aesirkth/surtr-hardware/launchpad-controller-v2.jpg

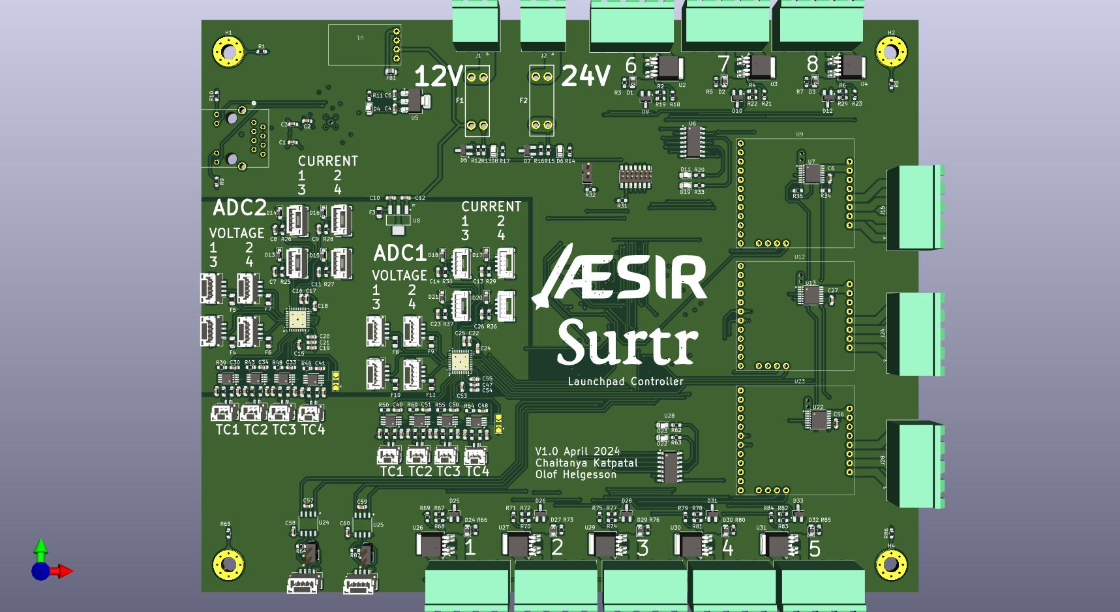
launchpad-controller-v2.jpg
