aesirkth/surtr-hardware/launchpad-controller-v2.png

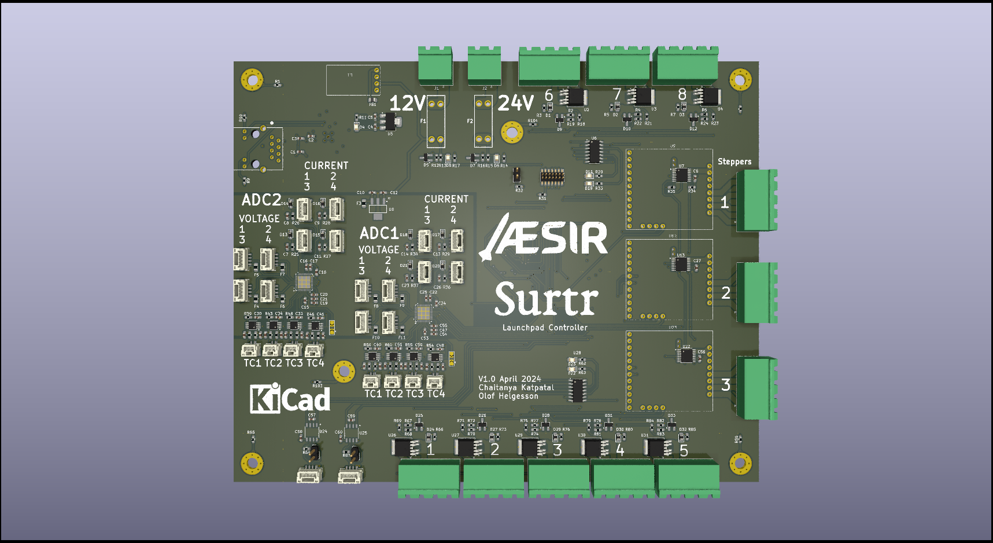
launchpad-controller-v2.png
