aesirkth/surtr-hardware/pdf/launchpad-controller-v2.pdf

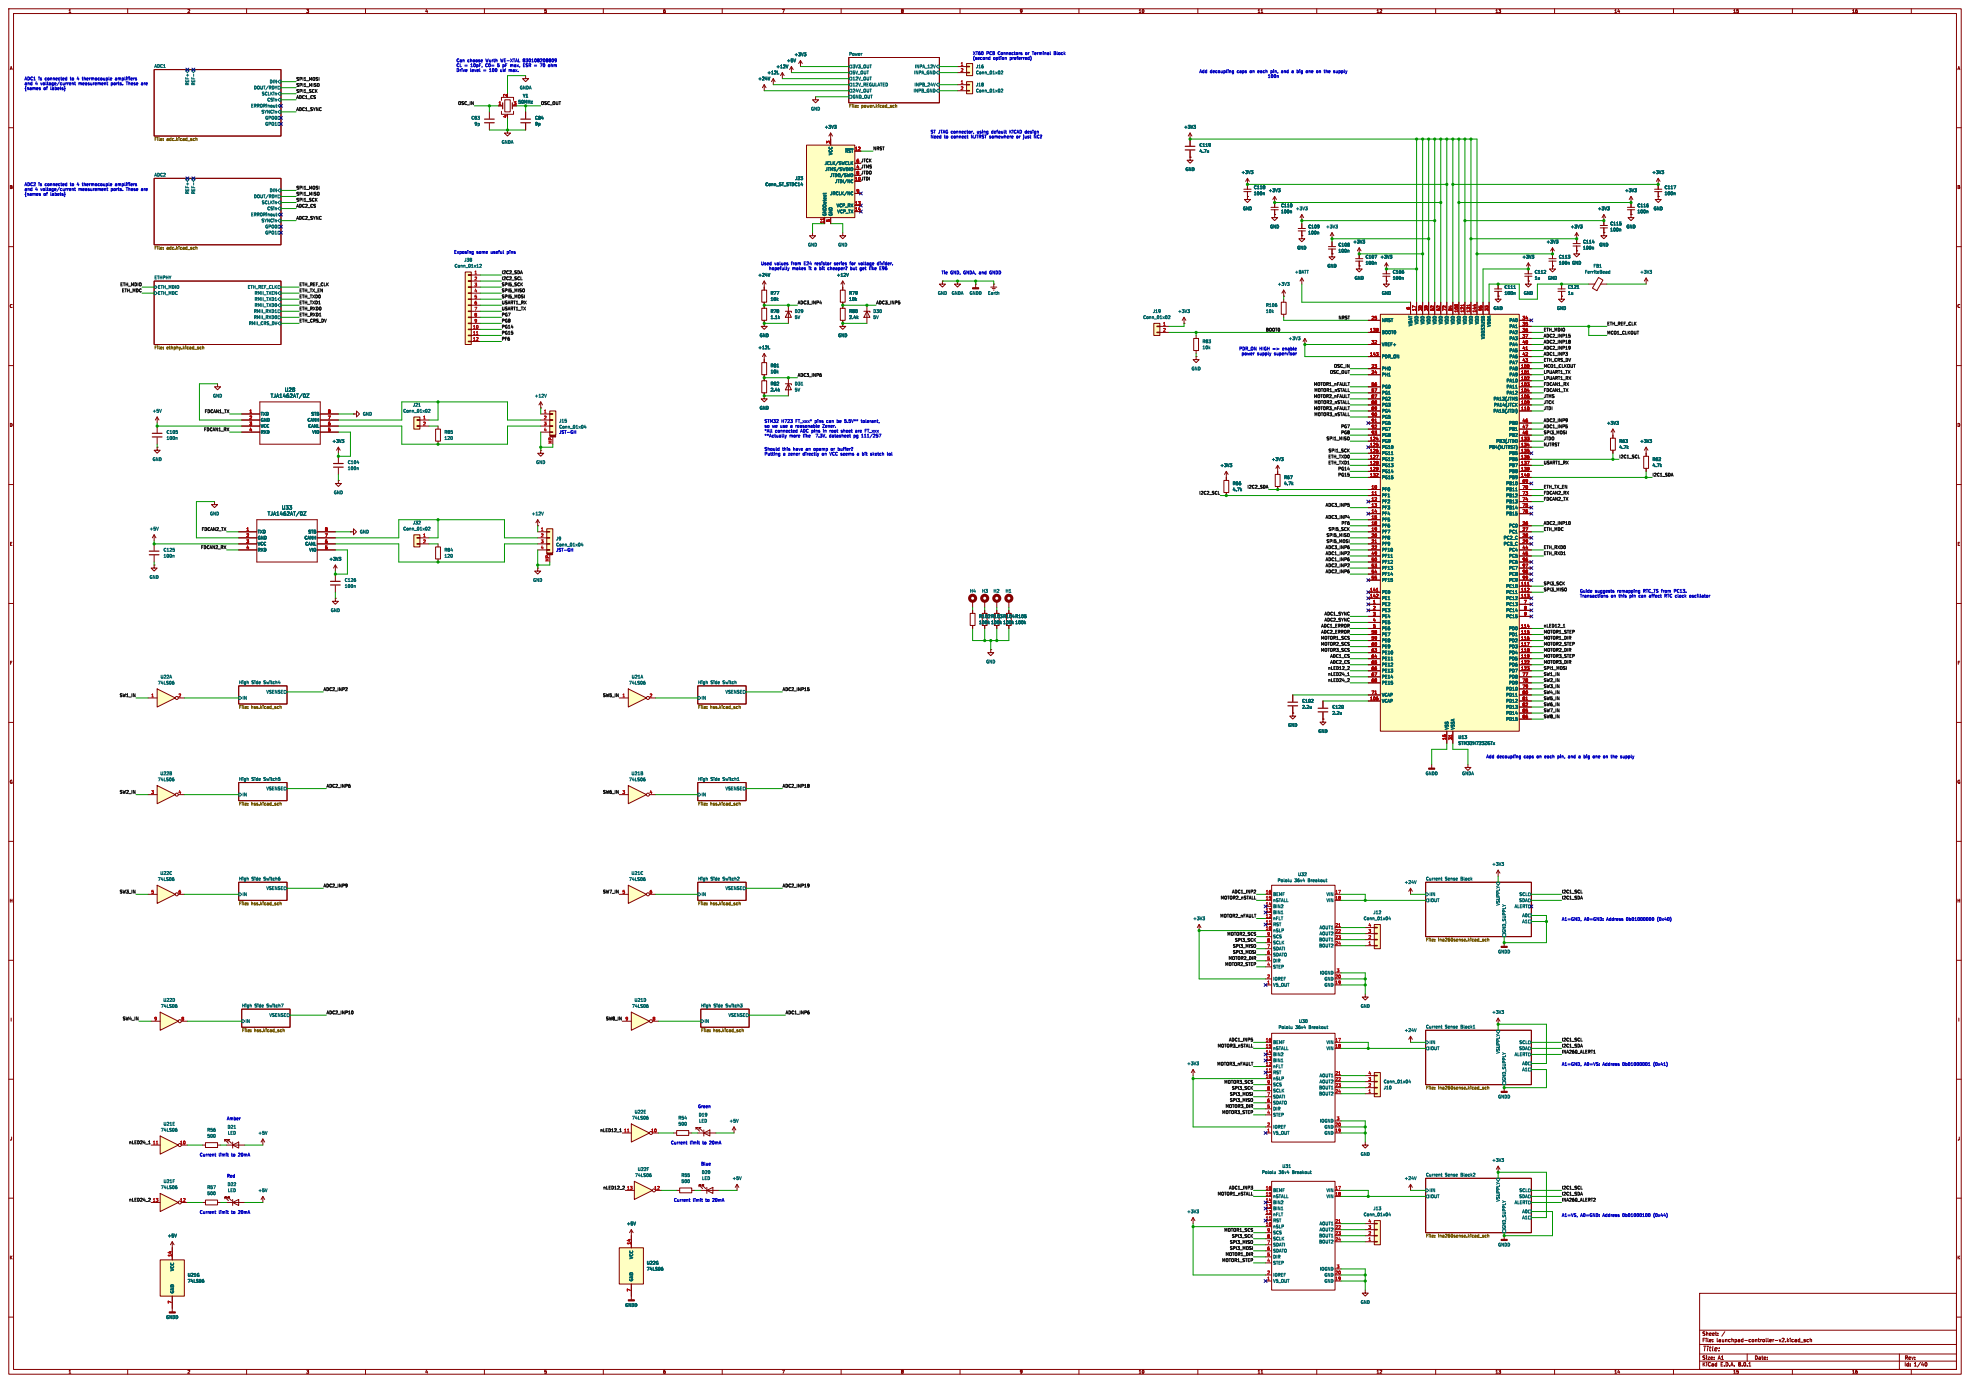
[picture p3: page 1]

Drive level = 100 uW max.

Tie GND, GNDA, and GNDD

VSENSE High Side Switch4 File: hss.kicad_sch

VSENSE High Side Switch File: hss.kicad_sch

VSENSE High Side Switch1 File: hss.kicad_sch

VSENSE High Side Switch6 File: hss.kicad_sch

VSENSE High Side Switch2 File: hss.kicad_sch

VSENSE High Side Switch7 File: hss.kicad_sch

VSENSE High Side Switch3 File: hss.kicad_sch

Amber Current limit to 20mA

Id: 1/40 Title: File: launchpad-controller-v2.kicad_sch Sheet: /

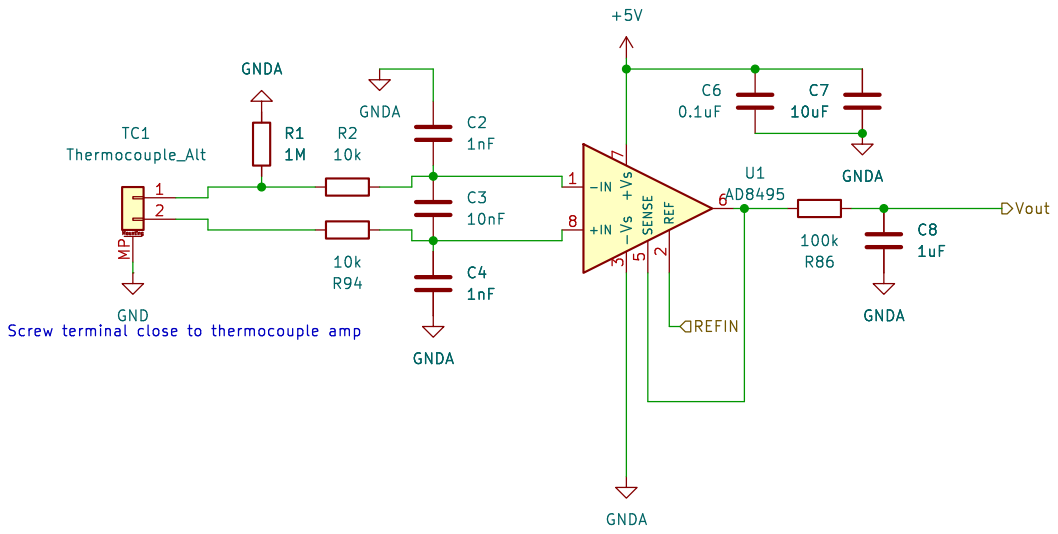
[picture p4: page 2]

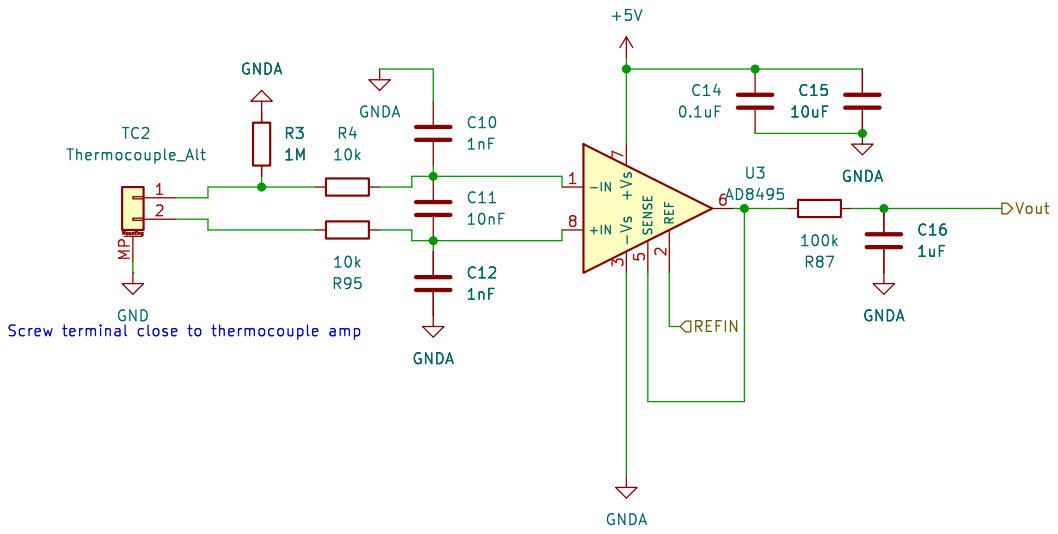
[picture p5: page 3]

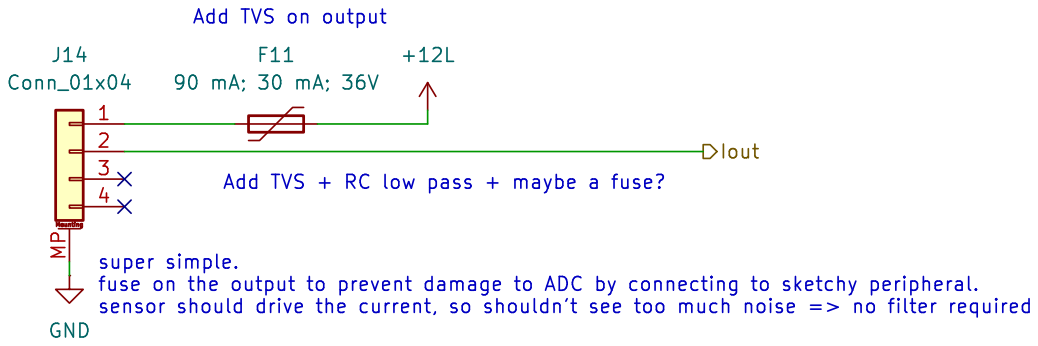
[picture p6: page 4]

Iout Add TVS on output Add TVS + RC low pass + maybe a fuse?
J14 Conn_01x04 GND

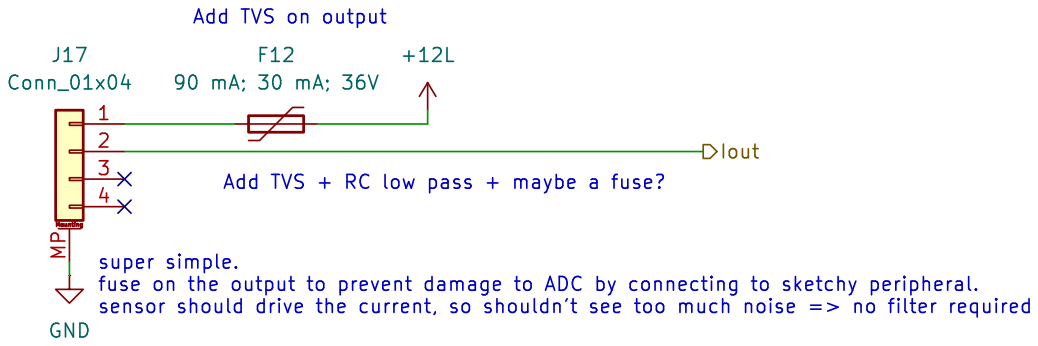
[picture p7: page 5]

Iout Add TVS on output Add TVS + RC low pass + maybe a fuse?
J17 Conn_01x04 GND

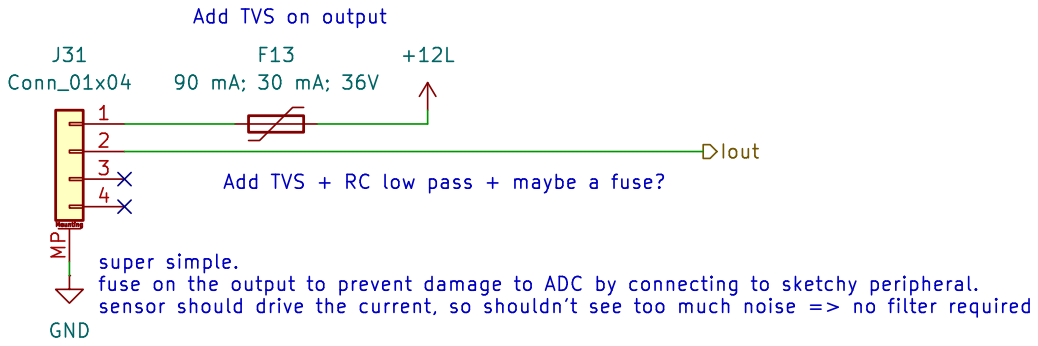
[picture p8: page 6]

Iout Add TVS on output Add TVS + RC low pass + maybe a fuse?
J31 Conn_01x04 GND

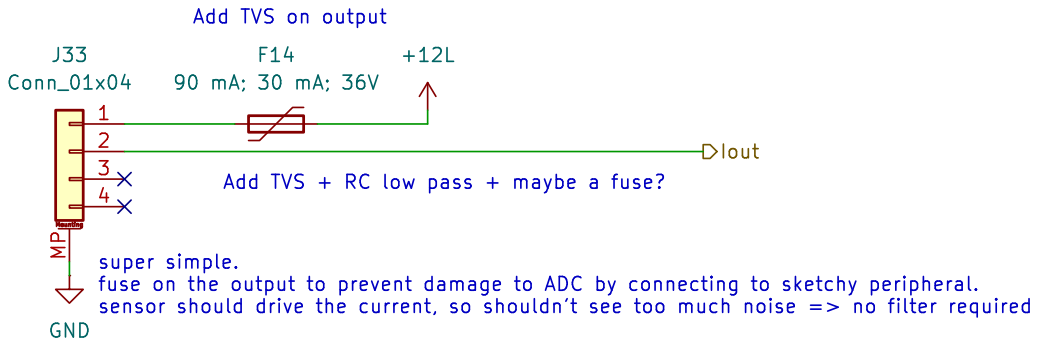
[picture p9: page 7]

Iout Add TVS on output Add TVS + RC low pass + maybe a fuse?
J33 Conn_01x04 GND

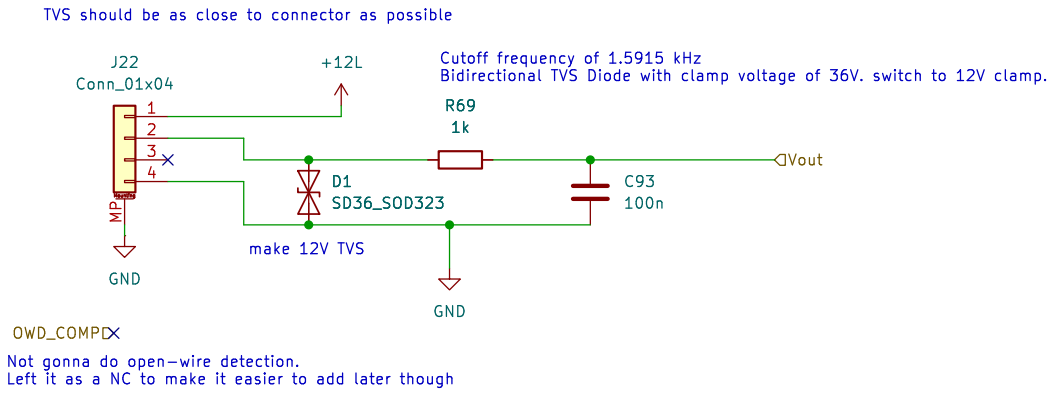
[picture p10: page 8]

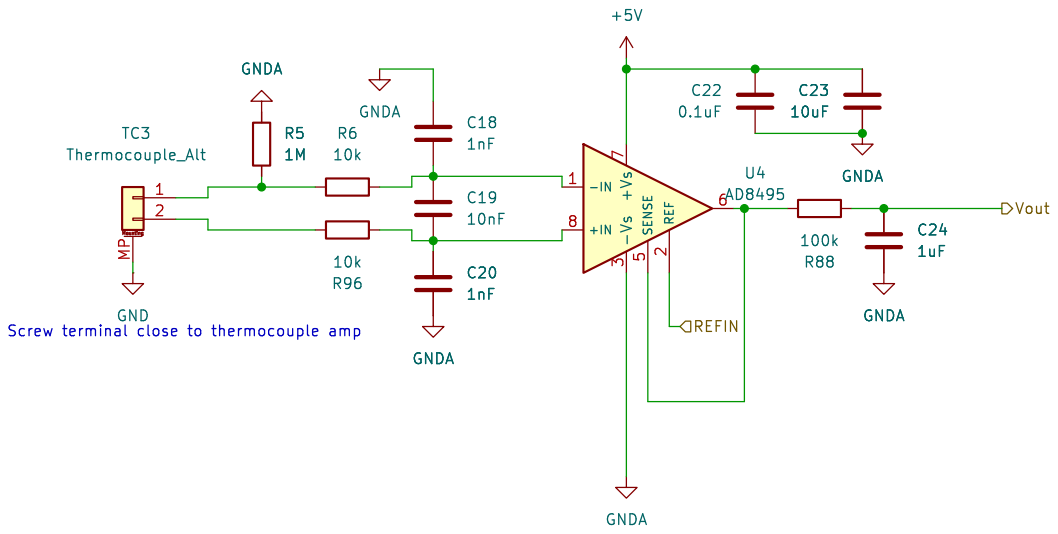
[picture p11: page 9]

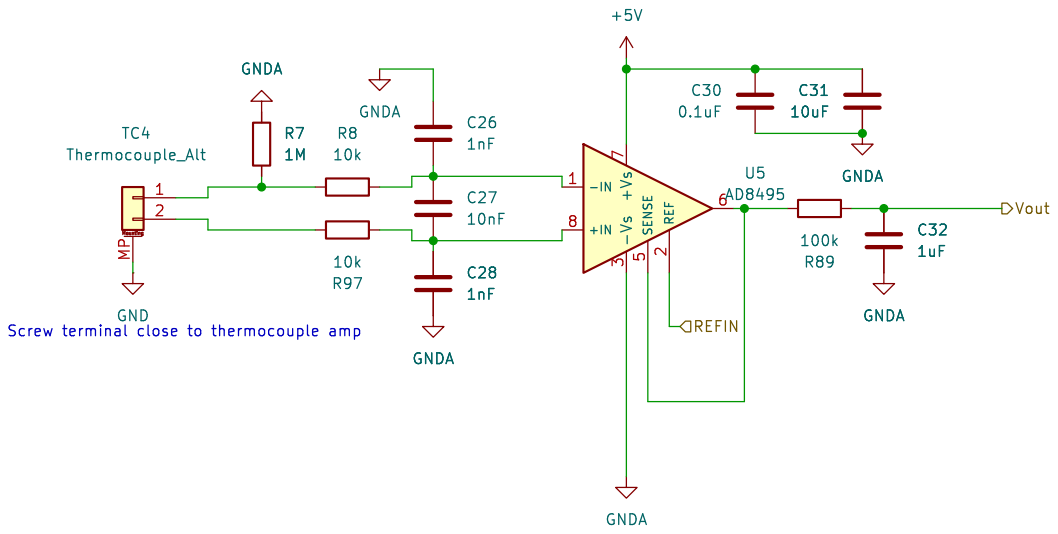
[picture p12: page 10]

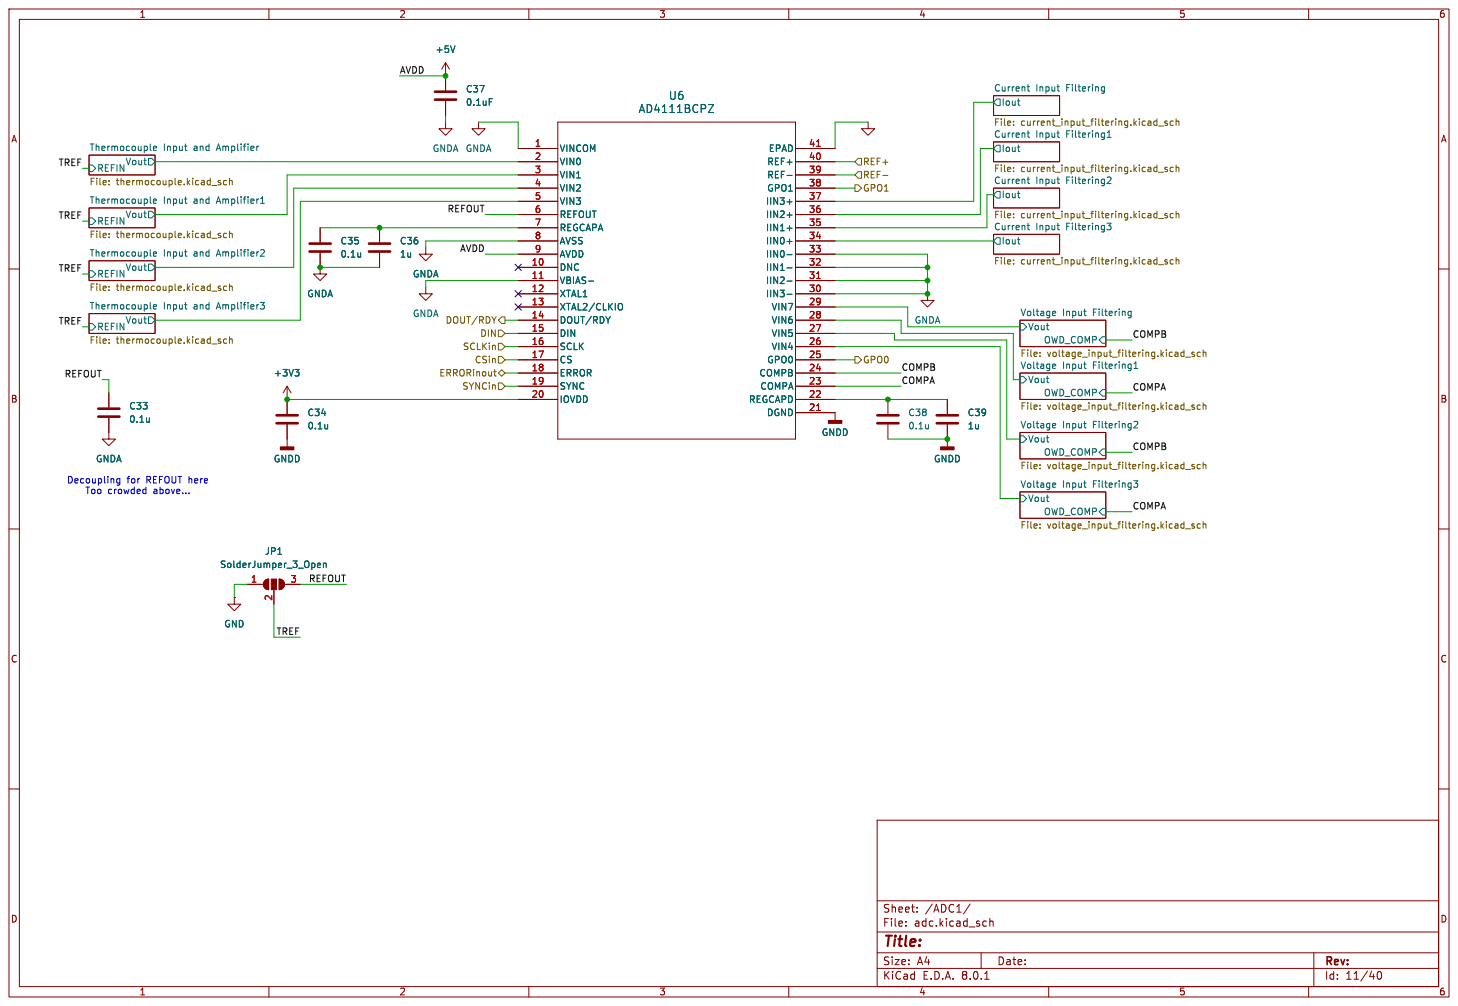
[picture p13: page 11]

Iout Current Input Filtering File: current_input_filtering.kicad_sch Vout REFIN

Iout Current Input Filtering1 File: current_input_filtering.kicad_sch

Voltage Input Filtering File: voltage_input_filtering.kicad_sch Vout REFIN

Iout Current Input Filtering2 File: current_input_filtering.kicad_sch

Iout Current Input Filtering3 File: current_input_filtering.kicad_sch VoutOWD_COMP

Id: 11/40 Title: File: adc.kicad_sch Sheet: /ADC1/

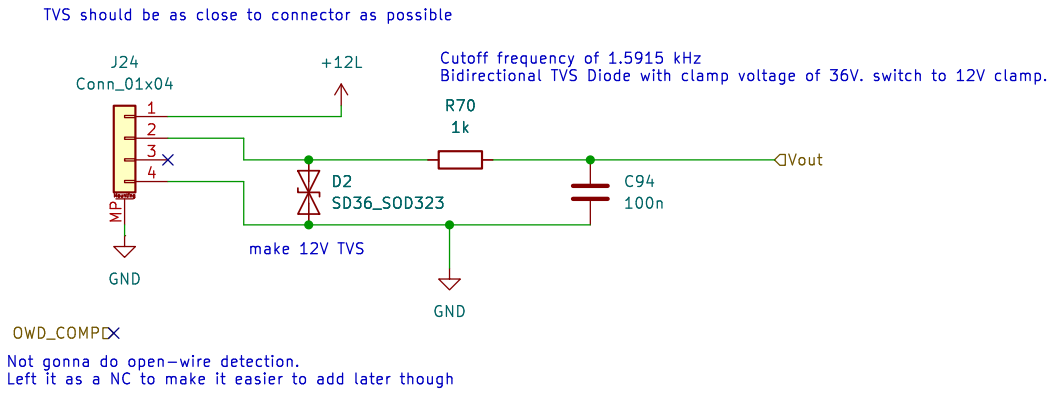
[picture p14: page 12]

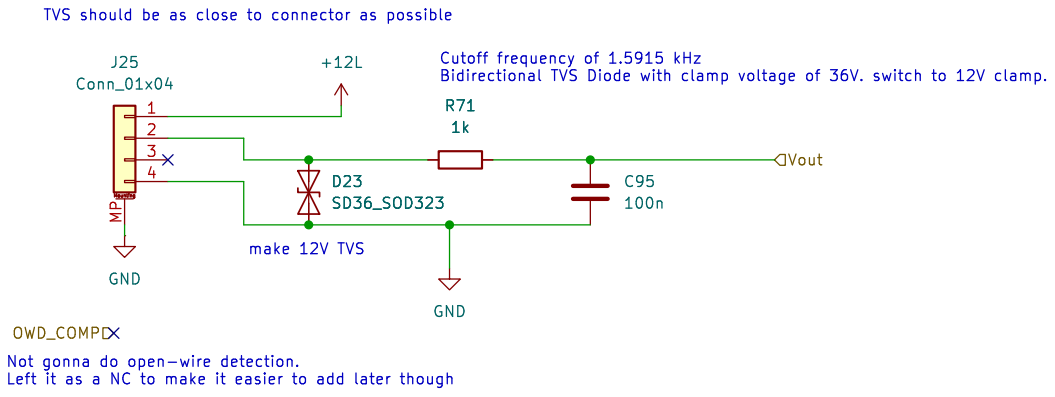
[picture p15: page 13]

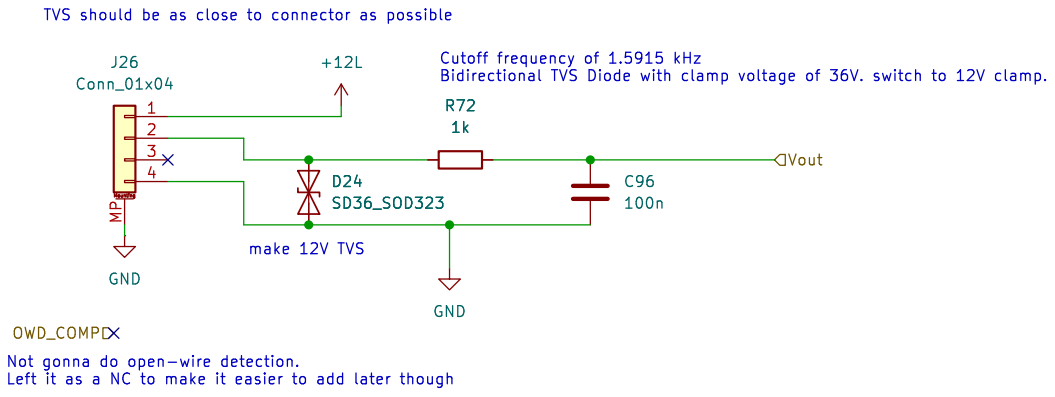
[picture p16: page 14]

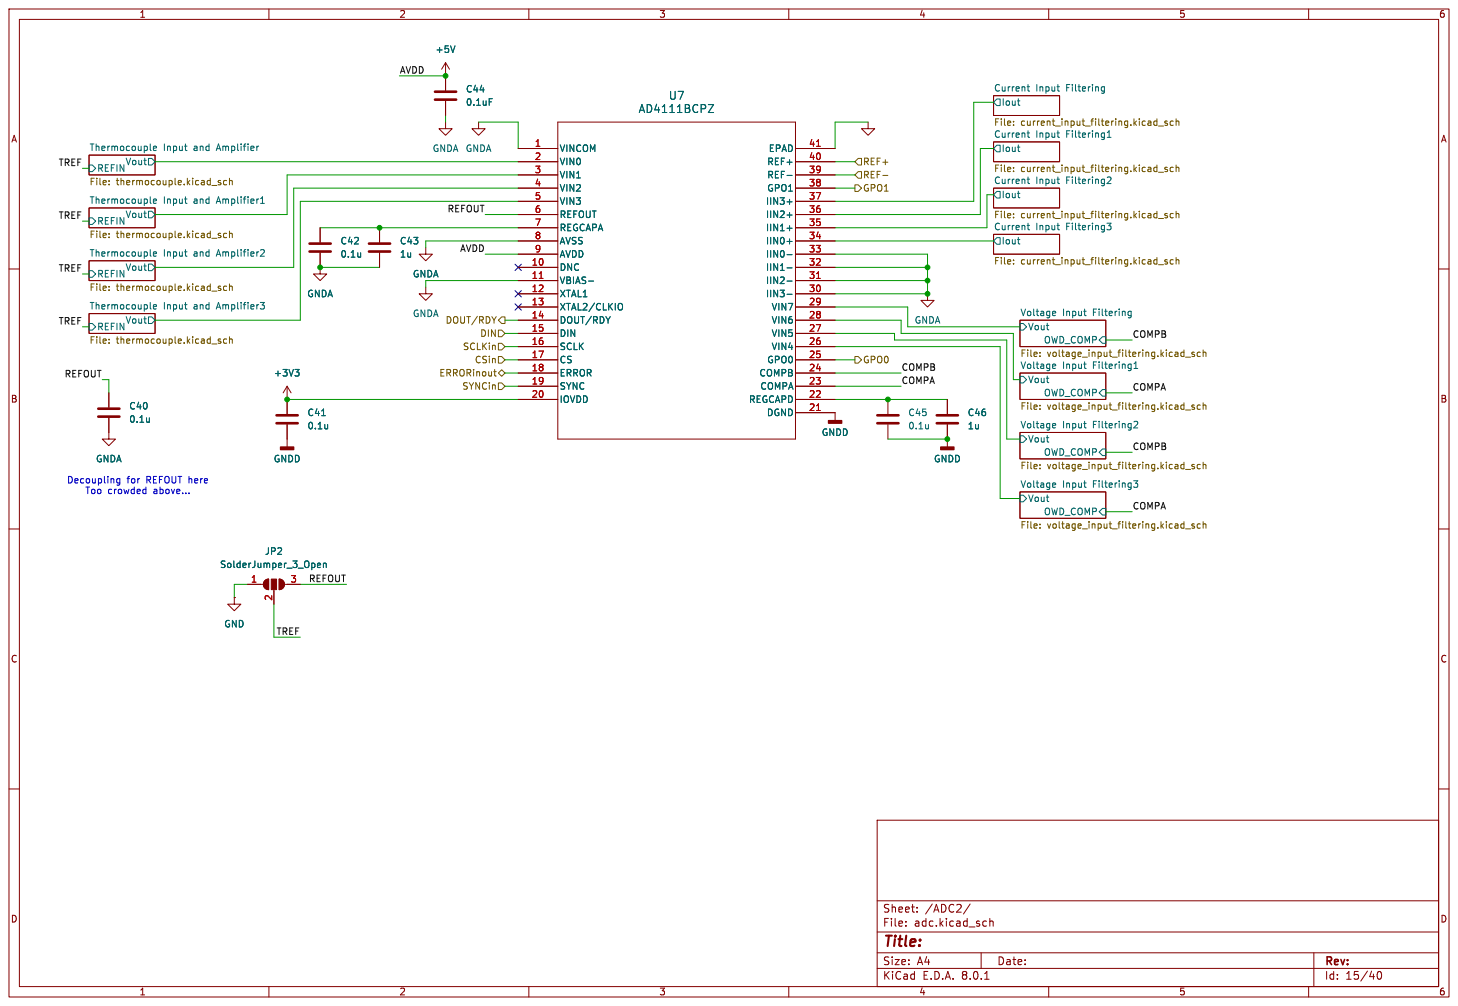
[picture p17: page 15]

Iout Current Input Filtering File: current_input_filtering.kicad_sch Vout REFIN

Iout Current Input Filtering1 File: current_input_filtering.kicad_sch

Iout Current Input Filtering2 File: current_input_filtering.kicad_sch

Iout Current Input Filtering3 File: current_input_filtering.kicad_sch VoutOWD_COMP

Voltage Input Filtering File: voltage_input_filtering.kicad_sch Vout REFIN

Id: 15/40 Title: File: adc.kicad_sch Sheet: /ADC2/

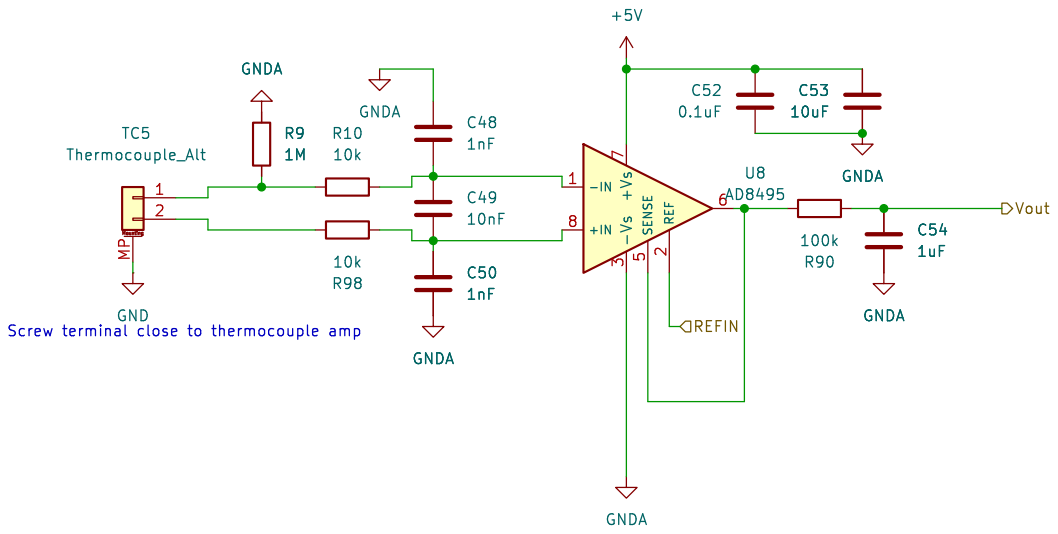
[picture p18: page 16]

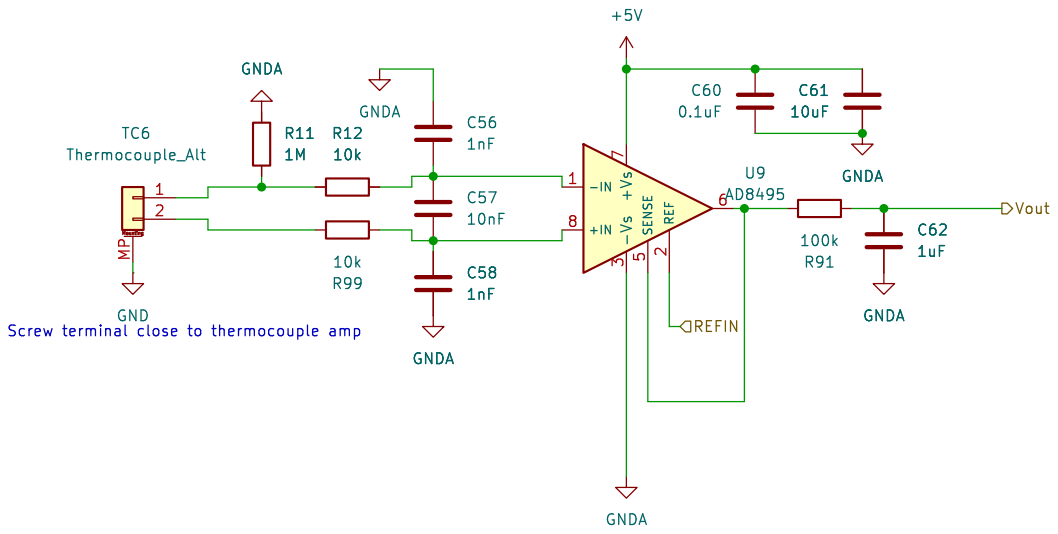
[picture p19: page 17]

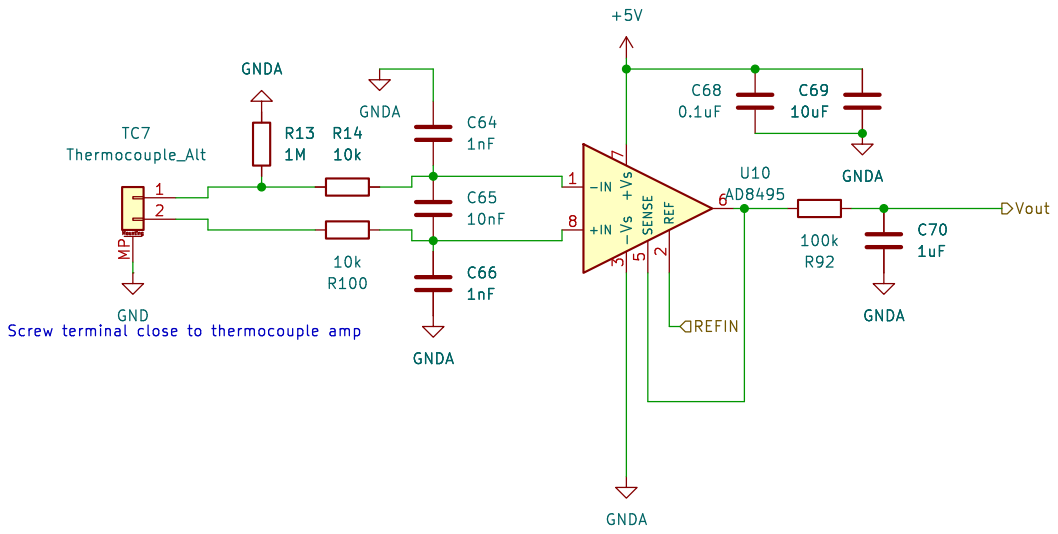
[picture p20: page 18]

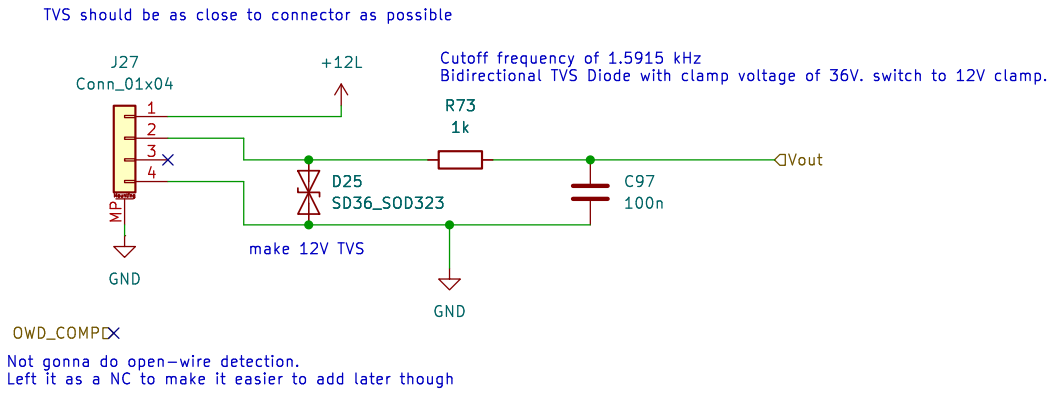
[picture p21: page 19]

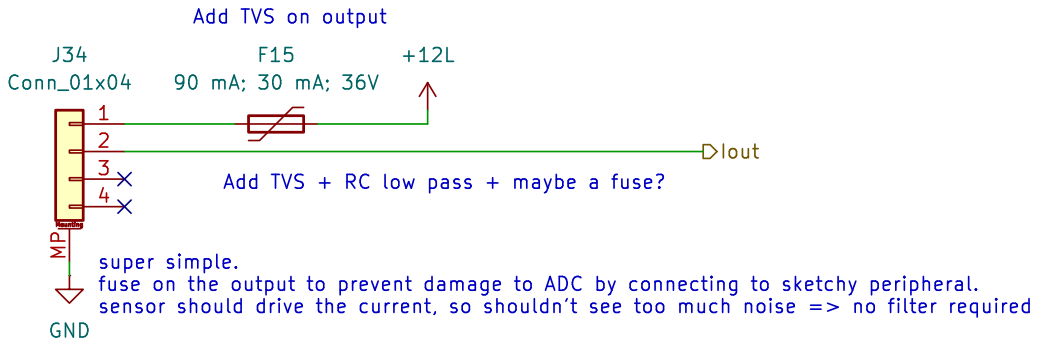
[picture p22: page 20]

Iout Add TVS on output Add TVS + RC low pass + maybe a fuse?
J34 Conn_01x04 GND

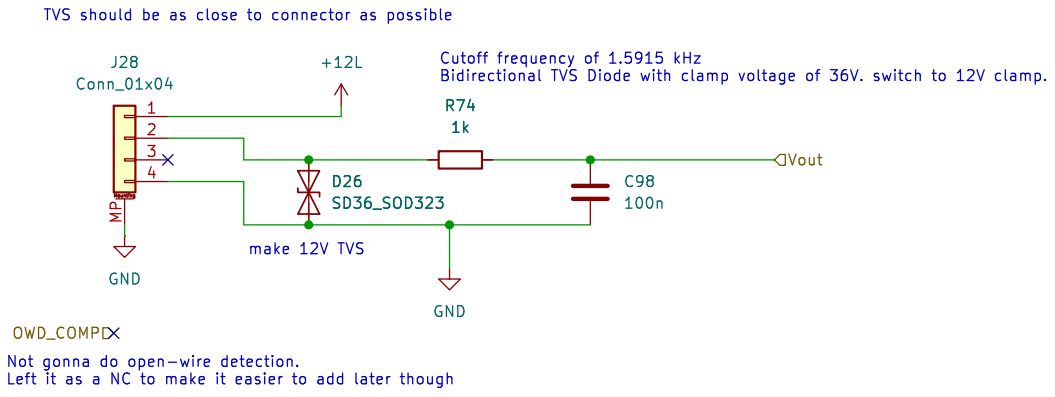
[picture p23: page 21]

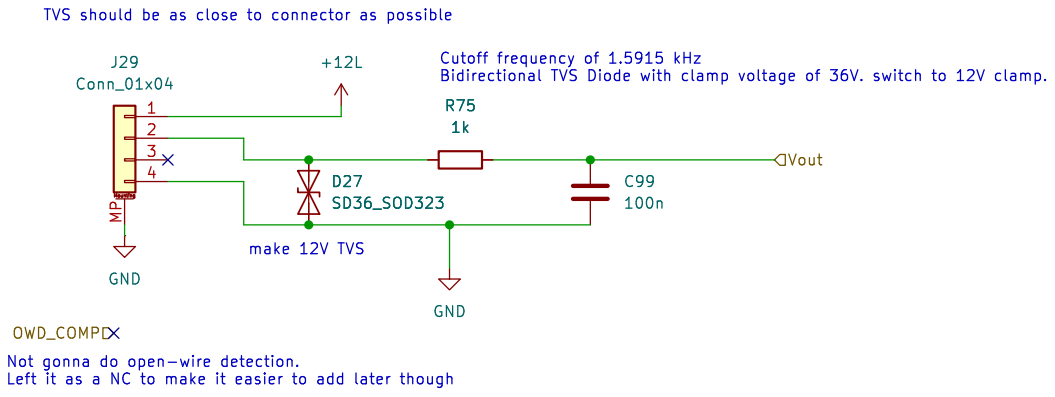
[picture p24: page 22]

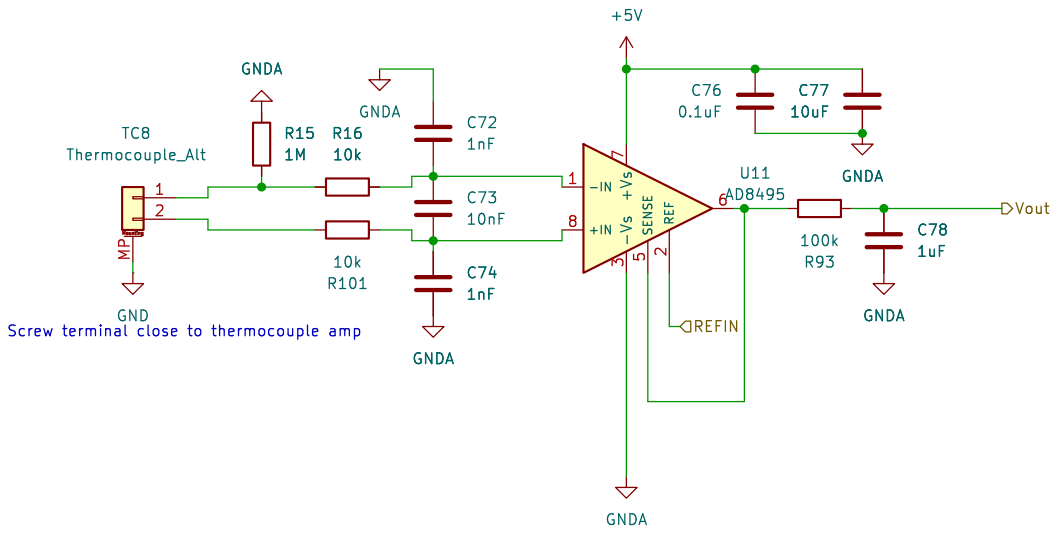
[picture p25: page 23]

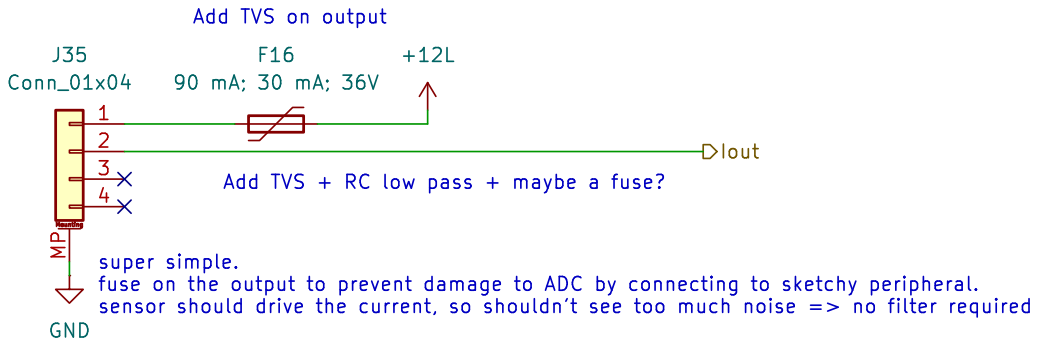
[picture p26: page 24]

Iout Add TVS on output Add TVS + RC low pass + maybe a fuse?
J35 Conn_01x04 GND

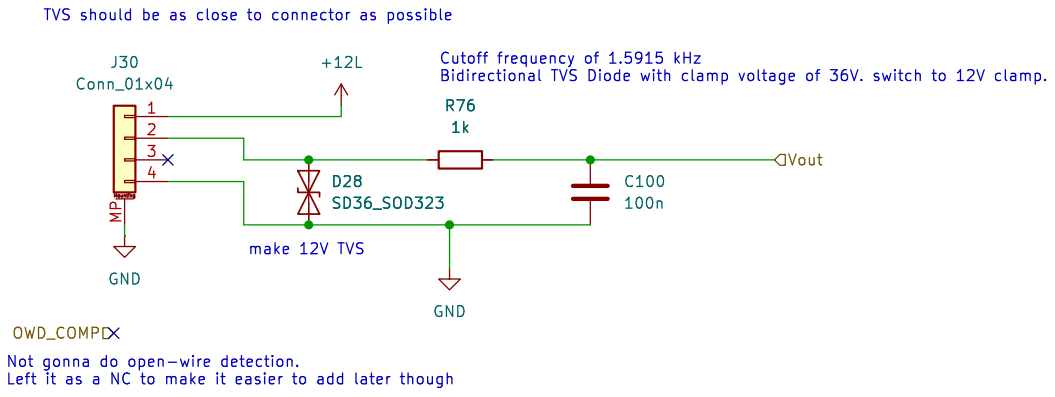
[picture p27: page 25]

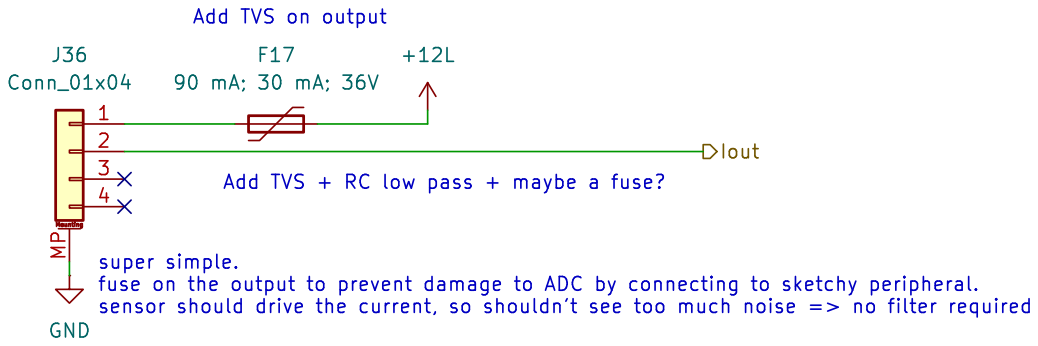
[picture p28: page 26]

Iout Add TVS on output Add TVS + RC low pass + maybe a fuse?
J36 Conn_01x04 GND

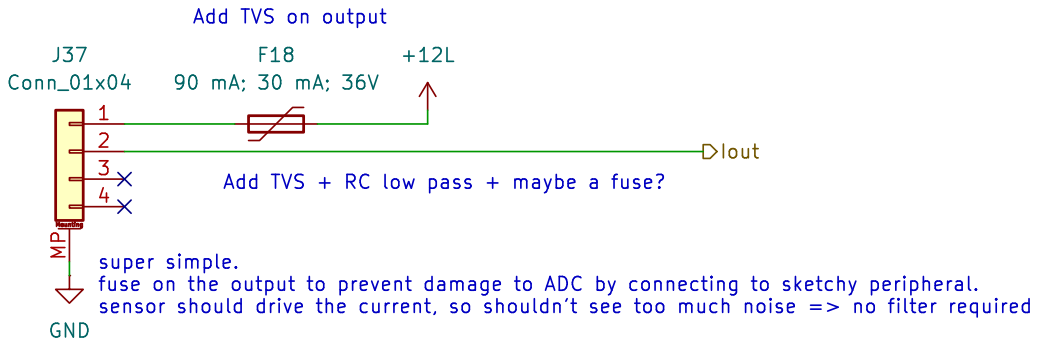
[picture p29: page 27]

Iout Add TVS on output Add TVS + RC low pass + maybe a fuse?
J37 Conn_01x04 GND

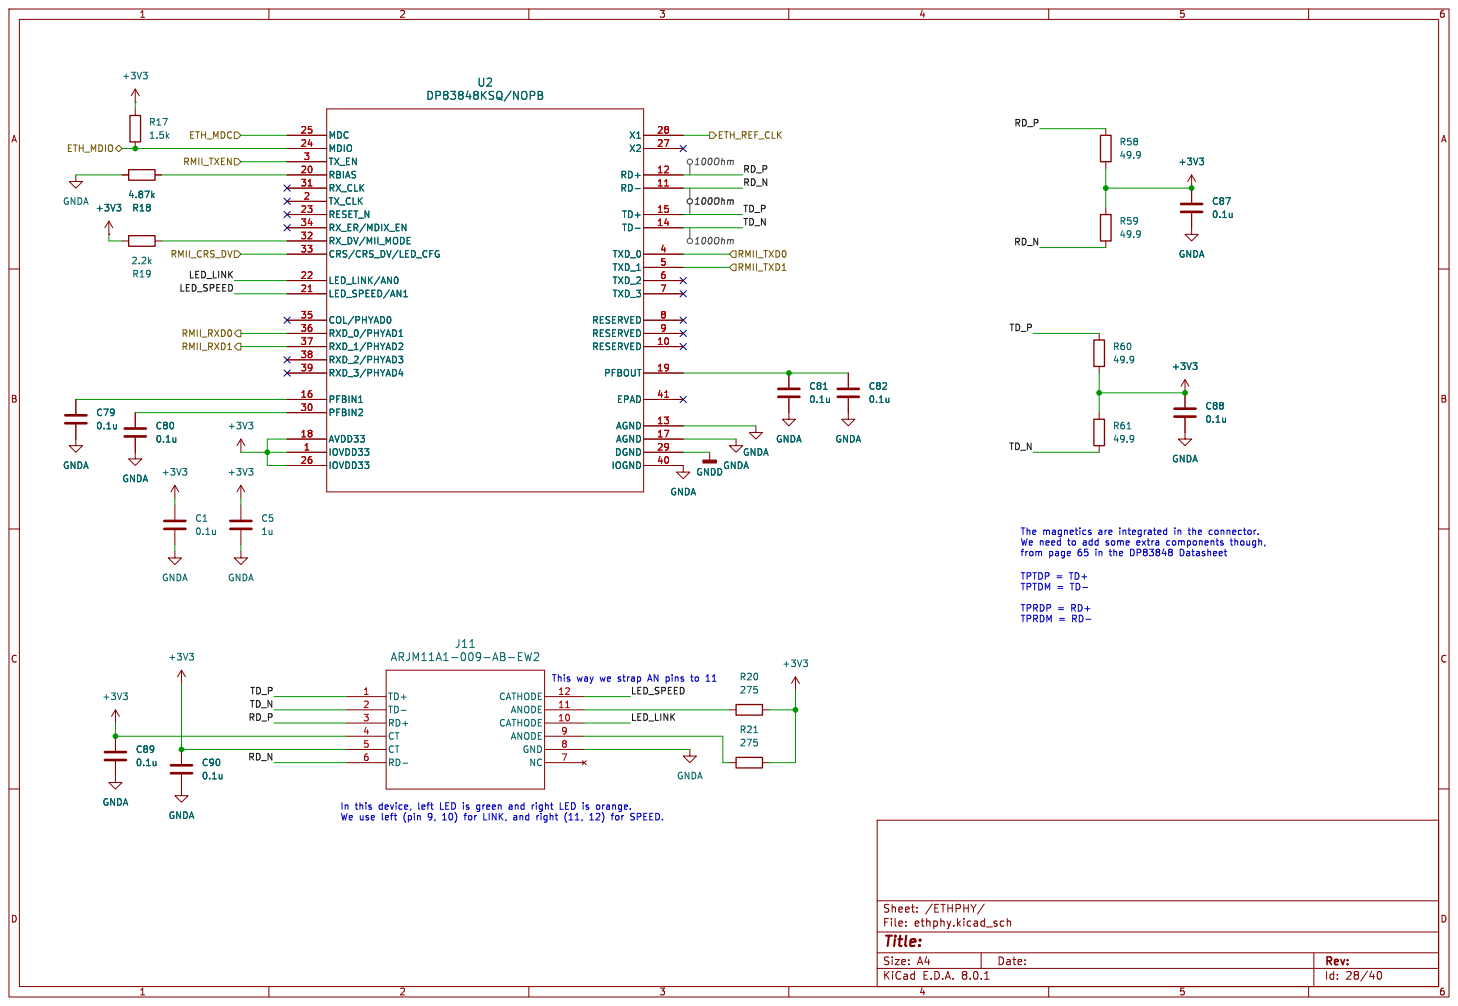
[picture p30: page 28]

This way we strap AN pins to 11

Id: 28/40 Title: File: ethphy.kicad_sch Sheet: /ETHPHY/

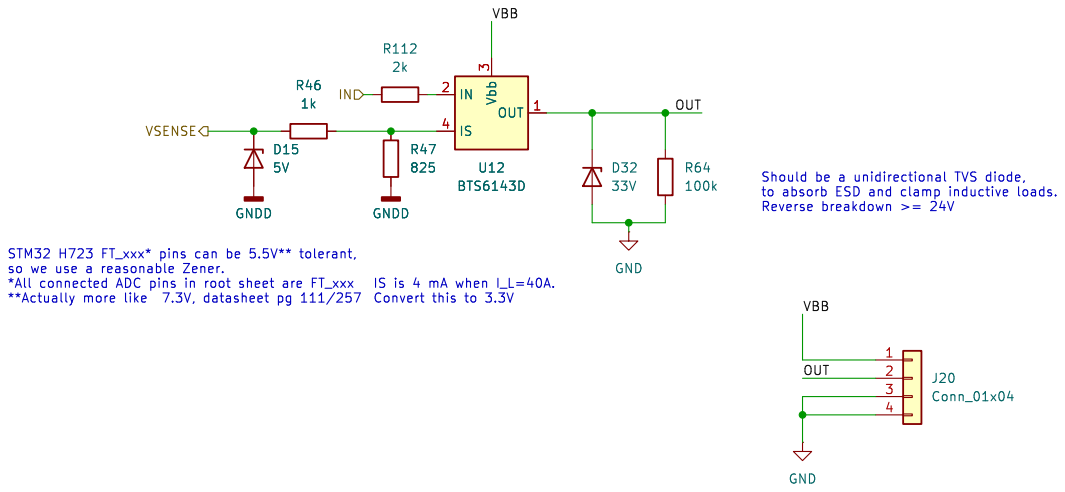
[picture p31: page 29]

IS is 4 mA when I_L=40A. Convert this to 3.3V

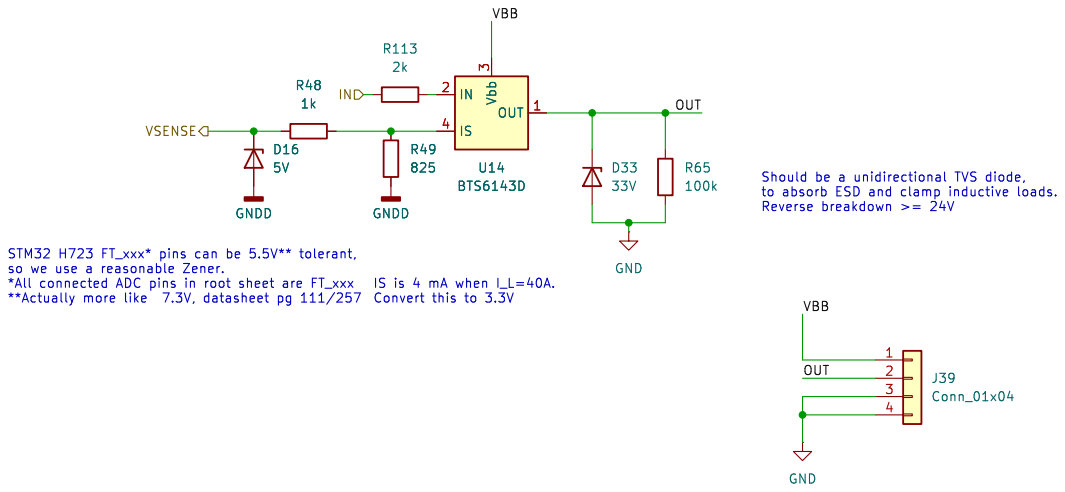
[picture p32: page 30]

IS is 4 mA when I_L=40A. Convert this to 3.3V

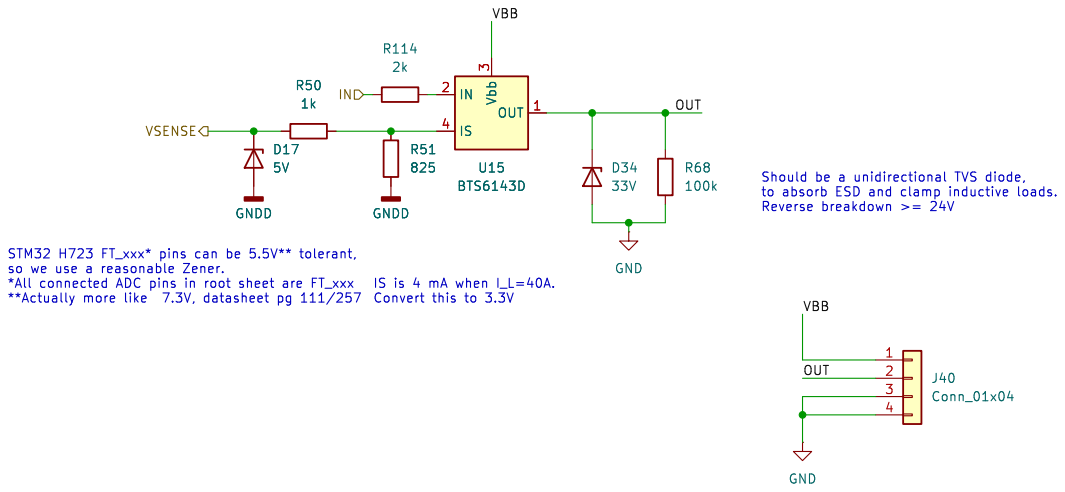
[picture p33: page 31]

IS is 4 mA when I_L=40A. Convert this to 3.3V

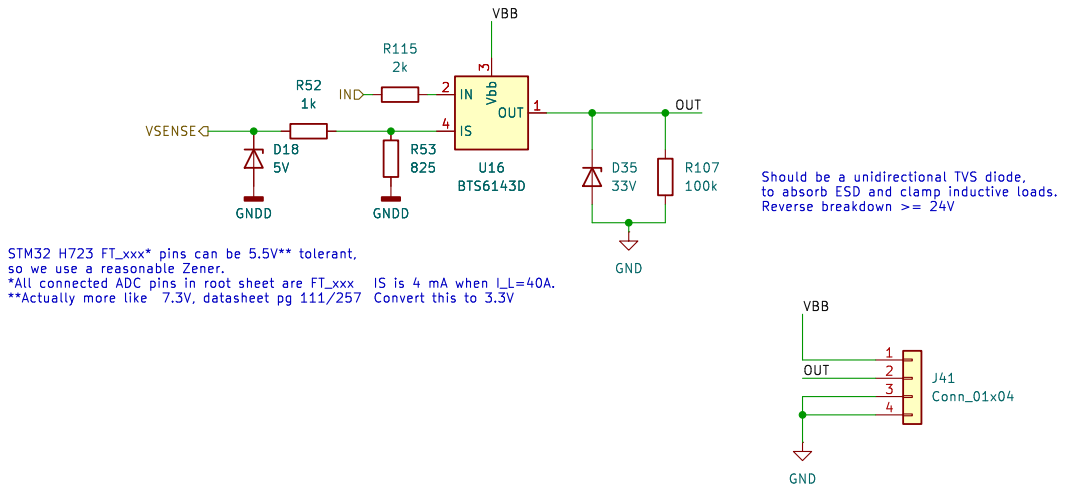
[picture p34: page 32]

IS is 4 mA when I_L=40A. Convert this to 3.3V

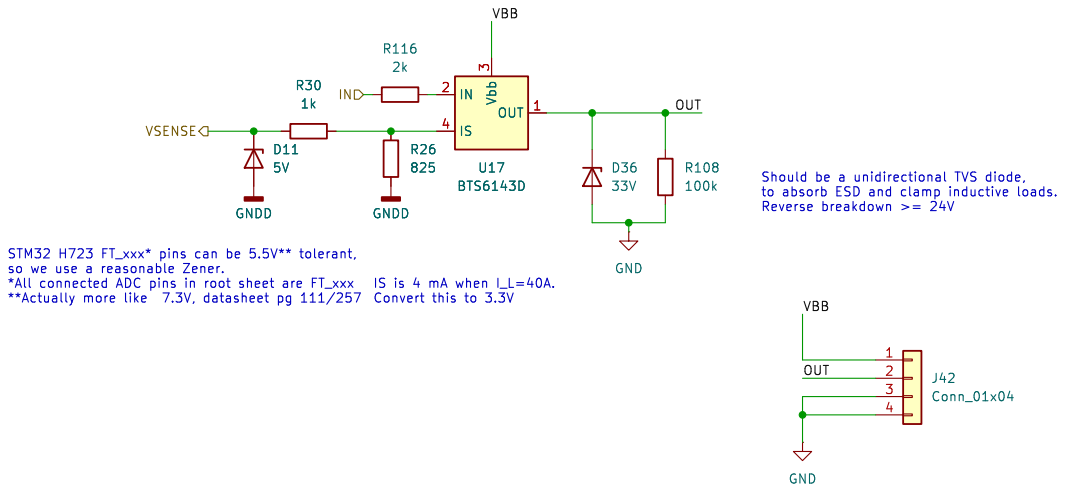
[picture p35: page 33]

IS is 4 mA when I_L=40A. Convert this to 3.3V

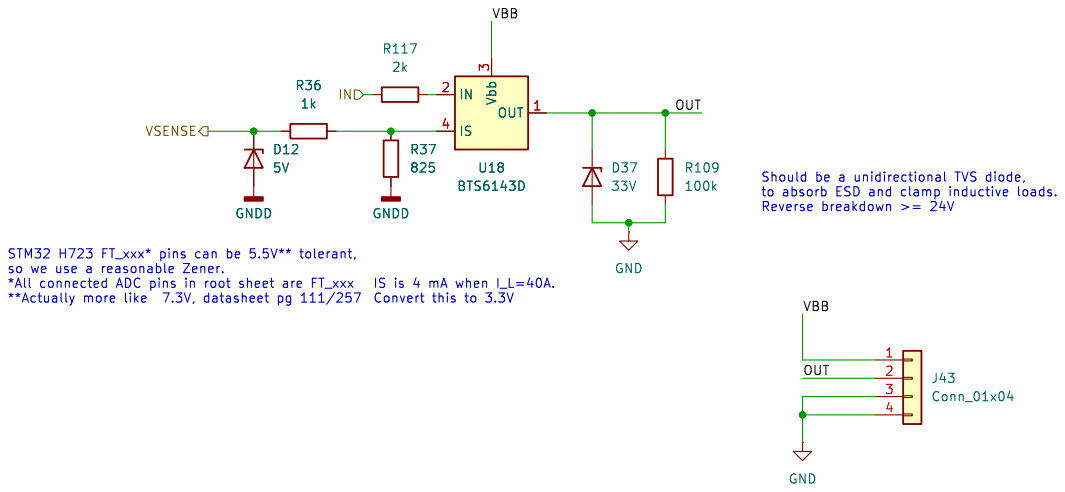
[picture p36: page 34]

IS is 4 mA when I_L=40A. Convert this to 3.3V

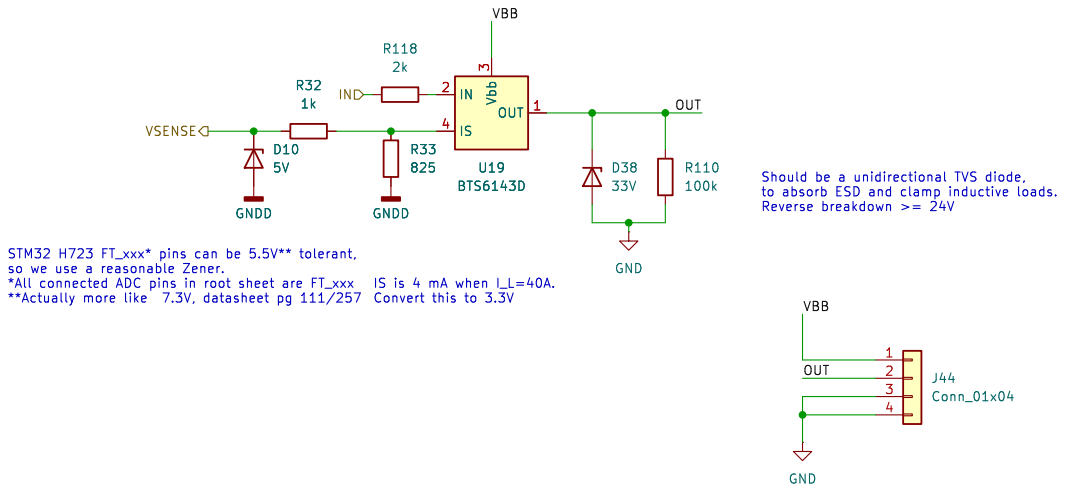
[picture p37: page 35]

IS is 4 mA when I_L=40A. Convert this to 3.3V

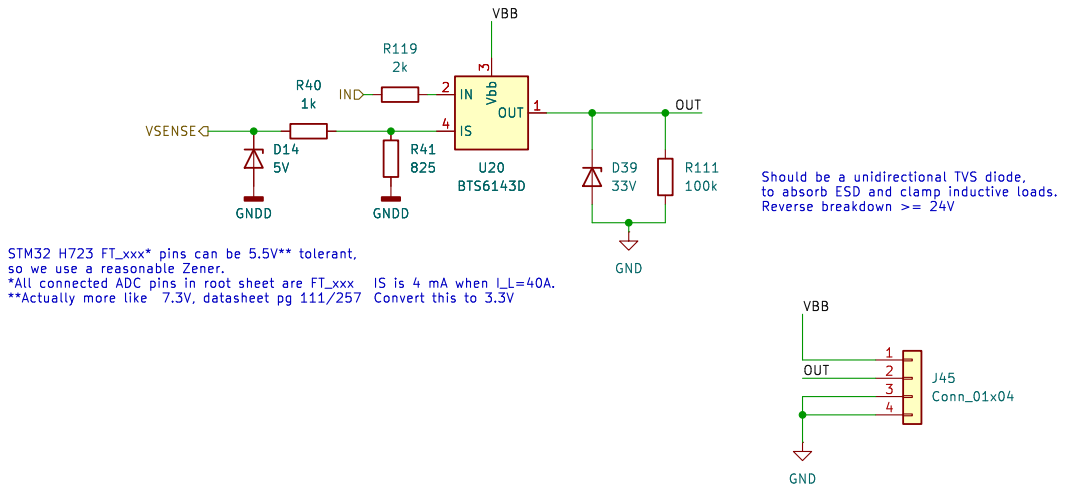
[picture p38: page 36]

IS is 4 mA when I_L=40A. Convert this to 3.3V

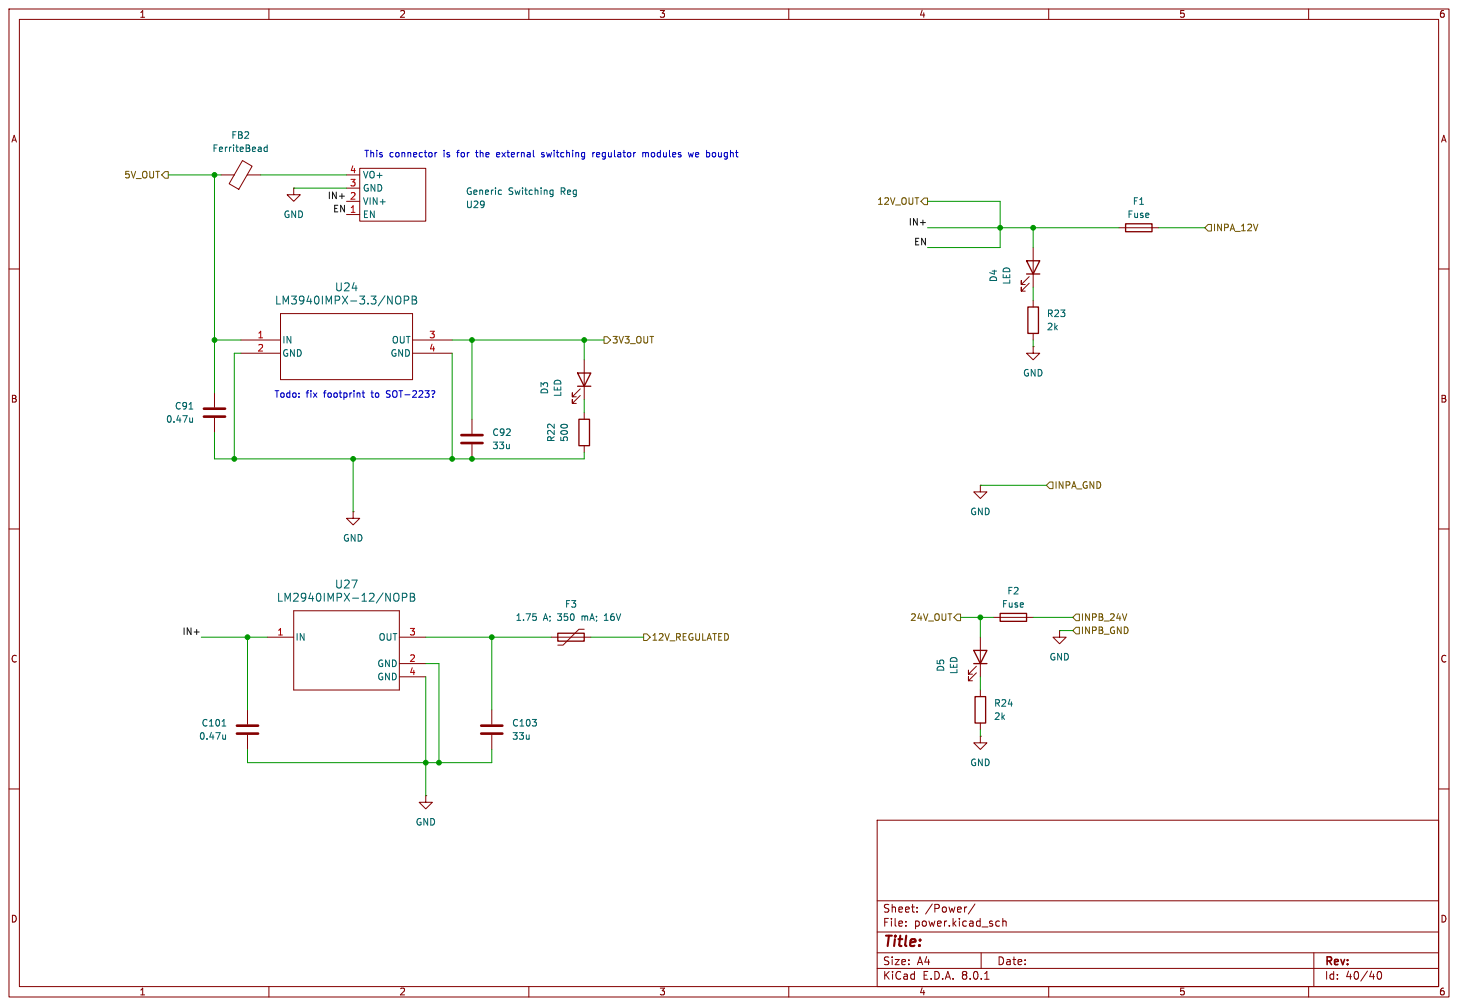
[picture p39: page 37]

Id: 40/40 Title: File: power.kicad_sch Sheet: /Power/

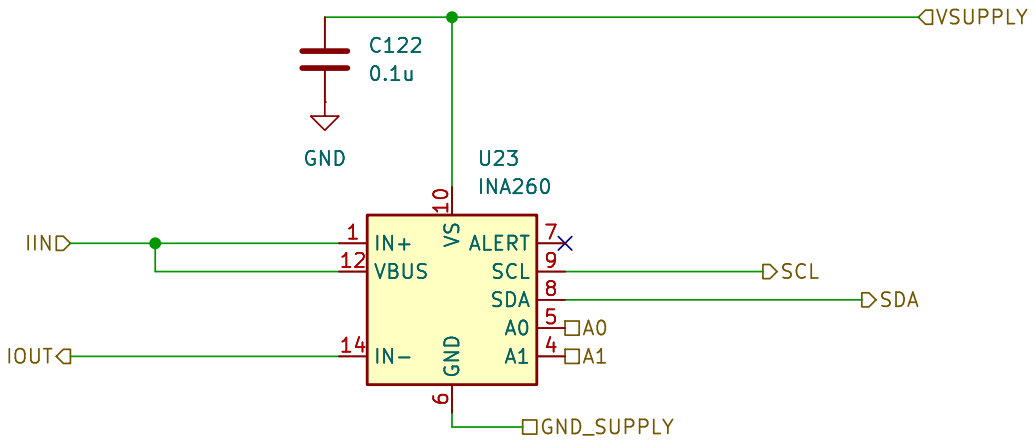
[picture p40: page 38]

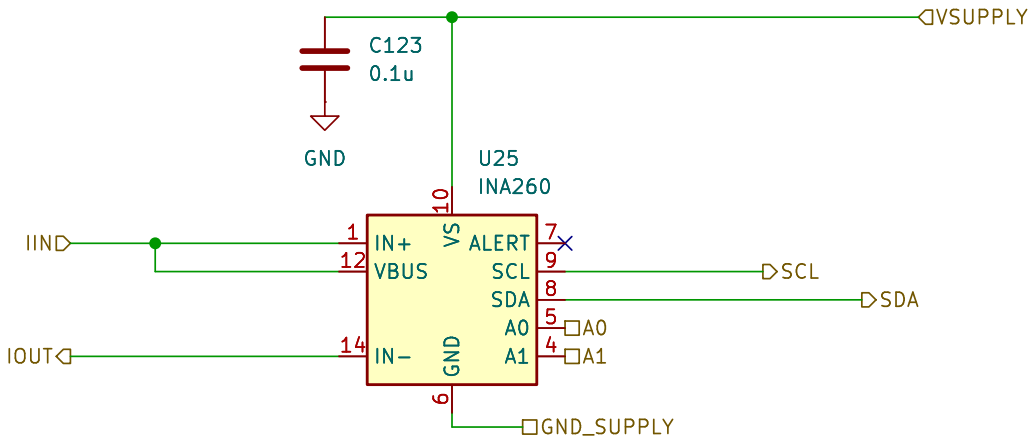
[picture p41: page 39]

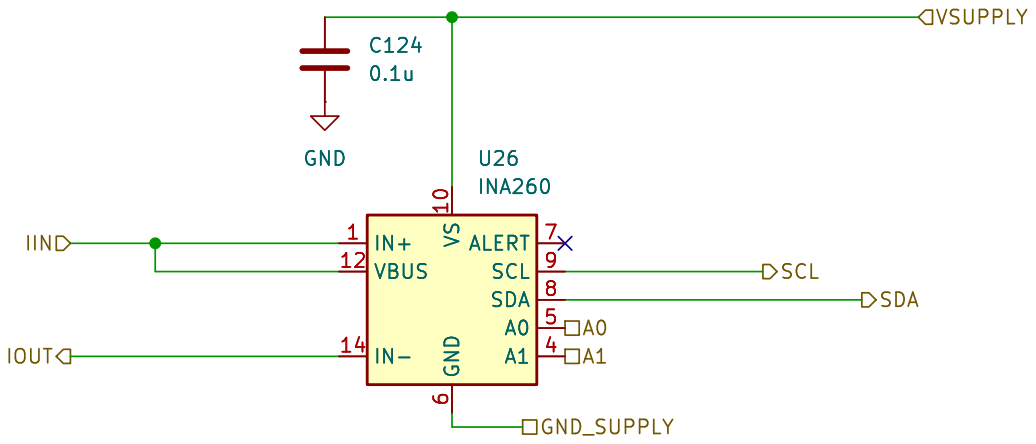
[picture p42: page 40]
