aesirkth/surtr-hardware/adc.kicad_sch

## KiCad design adc.kicad_sch (2024-05-01)

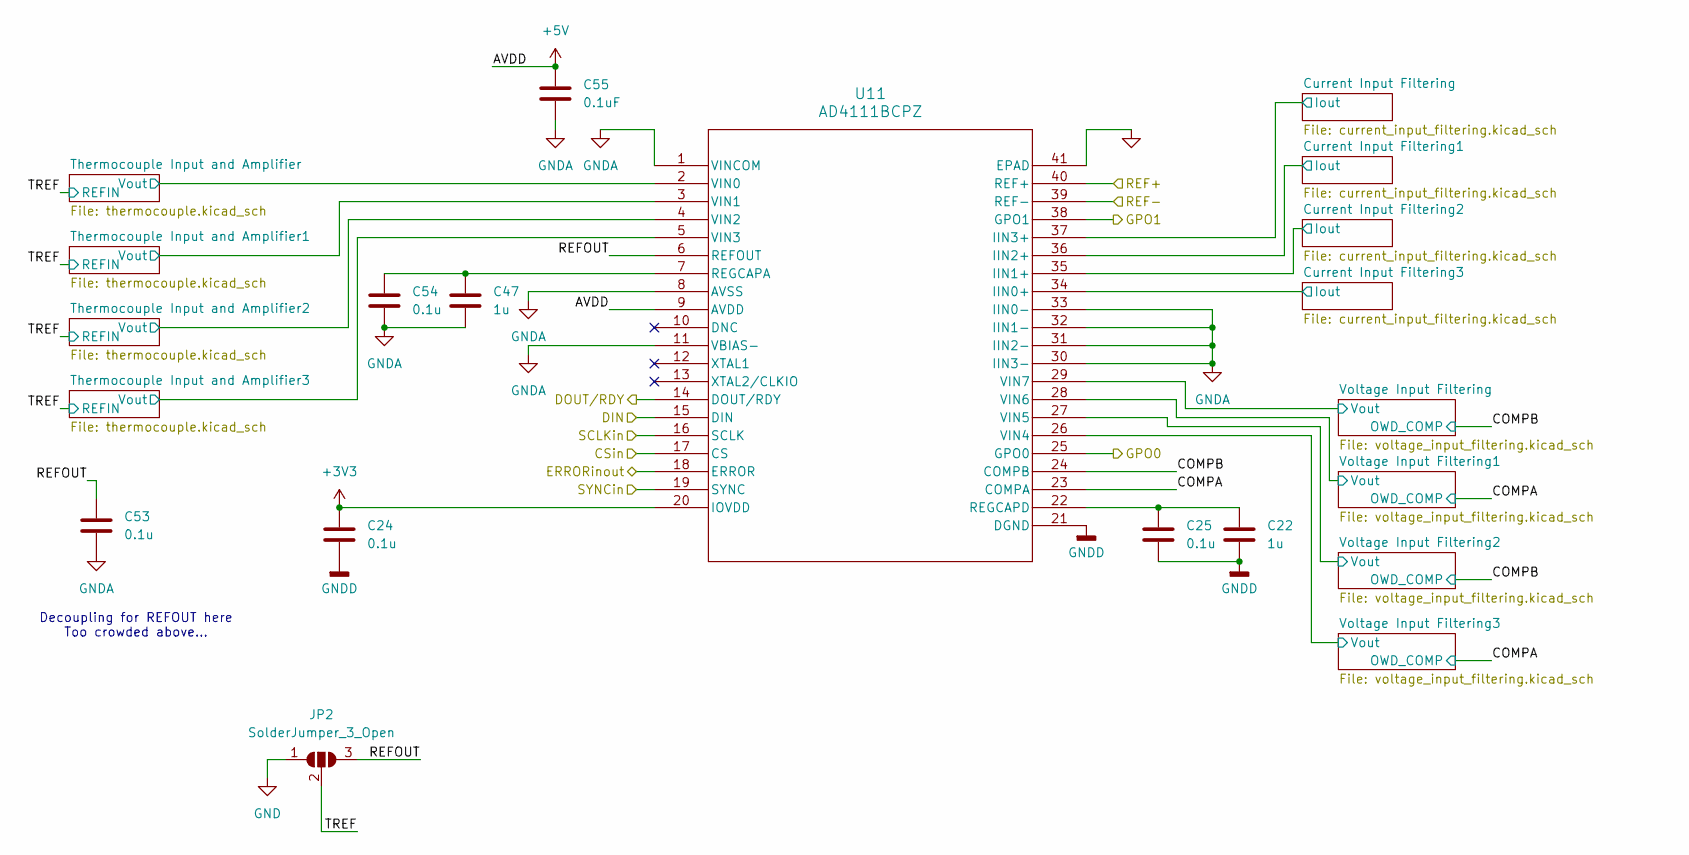
[picture p43: schematic adc.kicad_sch]

Parts:
C22, C47: 1u; C_0603_1608Metric_Pad1.08x0.95mm_HandSolder
C24, C25, C53, C54: 0.1u; C_0603_1608Metric_Pad1.08x0.95mm_HandSolder
C55: 0.1uF; C_0603_1608Metric_Pad1.08x0.95mm_HandSolder
JP2: SolderJumper_3_Open; SolderJumper-3_P2.0mm_Open_TrianglePad1.0x1.5mm
U11: AD4111BCPZ; AD4111BCPZ_ADI

Connections:
+3V3: C24.1, U11.20 (IOVDD)
+5V: C55.1, U11.9 (AVDD)
COMPA: U11.23 (COMPA)
COMPB: U11.24 (COMPB)
CSin: U11.17 (CS)
DIN: U11.15 (DIN)
DOUT/RDY: U11.14 (DOUT/RDY)
ERRORinout: U11.18 (ERROR)
GND: JP2.1 (A)
GNDA: C47.2, C53.2, C54.2, C55.2, U11.1 (VINCOM), U11.8 (AVSS), U11.11 (VBIAS-), U11.30 (IIN3-), U11.31 (IIN2-), U11.32 (IIN1-), U11.33 (IIN0-), U11.41 (EPAD)
GNDD: C22.2, C24.2, C25.2, U11.21 (DGND)
GPO0: U11.25 (GPO0)
GPO1: U11.38 (GPO1)
Iout: U11.34 (IIN0+), U11.35 (IIN1+), U11.36 (IIN2+), U11.37 (IIN3+)
unnamed: C22.1, C25.1, U11.22 (REGCAPD)
unnamed: C47.1, C54.1, U11.7 (REGCAPA)
REF+: U11.40 (REF+)
REF-: U11.39 (REF-)
REFOUT: C53.1, JP2.3 (B), U11.6 (REFOUT)
SCLKin: U11.16 (SCLK)
SYNCin: U11.19 (SYNC)
TREF: JP2.2 (C)
Vout: U11.2 (VIN0), U11.3 (VIN1), U11.4 (VIN2), U11.5 (VIN3), U11.26 (VIN4), U11.27 (VIN5), U11.28 (VIN6), U11.29 (VIN7)

Notes on the sheet:
Decoupling for REFOUT here Too crowded above...
