aesirkth/surtr-hardware/current_input_filtering.kicad_sch

## KiCad design current_input_filtering.kicad_sch (2024-05-01)

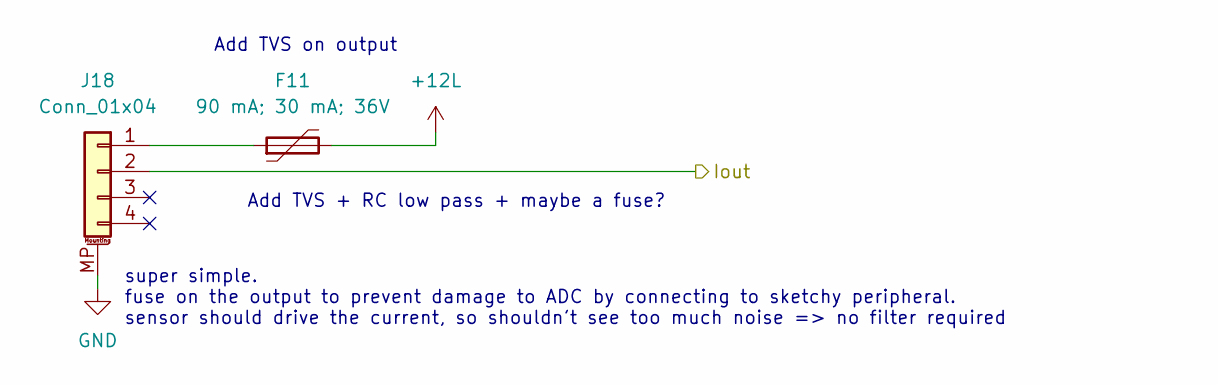
[picture p44: schematic current_input_filtering.kicad_sch]

Parts:
F11: 90 mA; 30 mA; 36V; Fuse_0805_2012Metric_Pad1.15x1.40mm_HandSolder; Mouser# 576-0603L003/36YR
J18: Conn_01x04; JST_GH_BM04B-GHS-TBT_1x04-1MP_P1.25mm_Vertical

Connections:
+12L: F11.2
GND: J18.MP (MountPin)
Iout: J18.2
unnamed: F11.1, J18.1

Notes on the sheet:
super simple. fuse on the output to prevent damage to ADC by connecting to sketchy peripheral. sensor should drive the current, so shouldn't see too much noise => no filter required
Add TVS + RC low pass + maybe a fuse?
Add TVS on output
