aesirkth/surtr-hardware/ethphy.kicad_sch

## KiCad design ethphy.kicad_sch (2024-05-01)

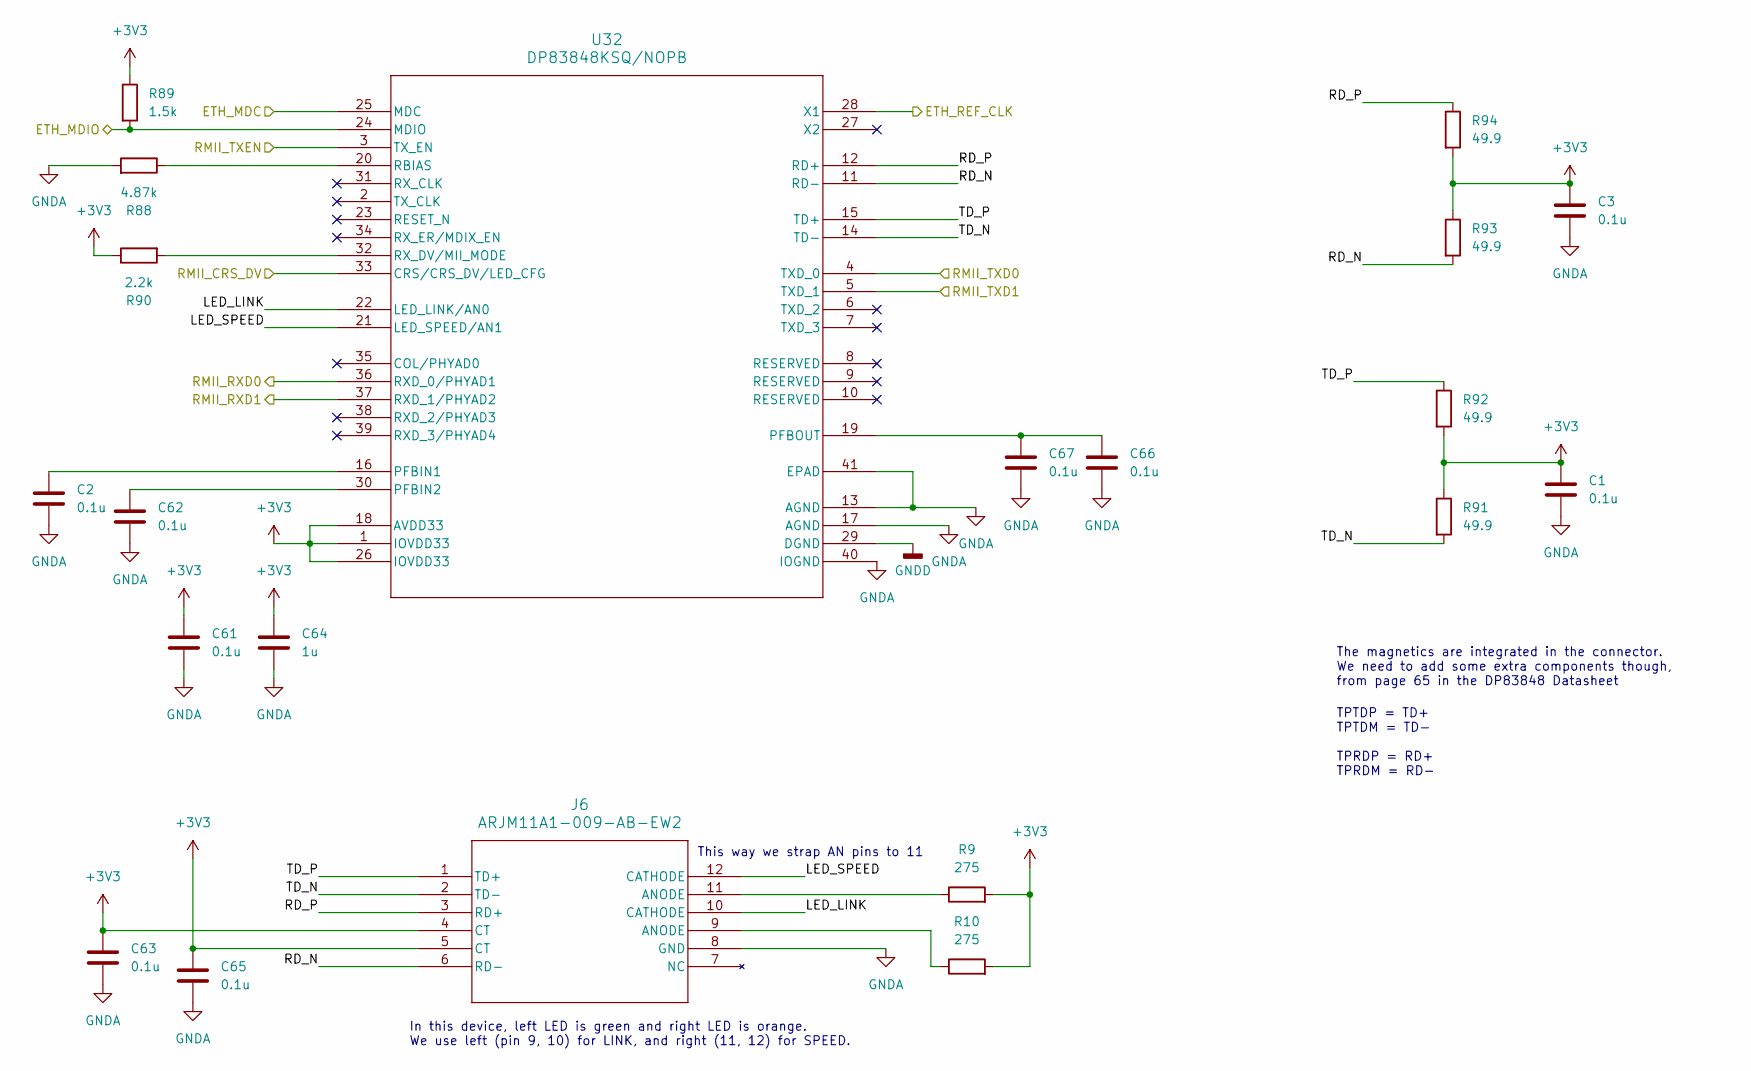
[picture p45: schematic ethphy.kicad_sch]

Parts:
C1, C2, C3, C61, C62, C63, C65, C66, C67: 0.1u; C_0603_1608Metric_Pad1.08x0.95mm_HandSolder
C64: 1u; C_0603_1608Metric_Pad1.08x0.95mm_HandSolder
J6: ARJM11A1-009-AB-EW2; ARJM11A1-009-AB-EW2_ABR
R9, R10: 275; R_0603_1608Metric_Pad0.98x0.95mm_HandSolder
R88: 4.87k; R_0603_1608Metric_Pad0.98x0.95mm_HandSolder; Tolerance 1%
R89: 1.5k; R_0603_1608Metric_Pad0.98x0.95mm_HandSolder
R90: 2.2k; R_0603_1608Metric_Pad0.98x0.95mm_HandSolder
R91, R92, R93, R94: 49.9; R_0603_1608Metric_Pad0.98x0.95mm_HandSolder
U32: DP83848KSQ/NOPB; RTA40

Connections:
+3V3: C1.1, C3.1, C61.1, C63.1, C64.1, C65.1, J6.4 (CT), J6.5 (CT), R9.2, R10.2, R89.1, R90.1, R91.1, R92.2, R93.1, R94.2, U32.1 (IOVDD33), U32.18 (AVDD33), U32.26 (IOVDD33)
ETH_MDC: U32.25 (MDC)
ETH_MDIO: R89.2, U32.24 (MDIO)
ETH_REF_CLK: U32.28 (X1)
GNDA: C1.2, C2.2, C3.2, C61.2, C62.2, C63.2, C64.2, C65.2, C66.2, C67.2, J6.8 (GND), R88.2, U32.13 (AGND), U32.17 (AGND), U32.40 (IOGND), U32.41 (EPAD)
GNDD: U32.29 (DGND)
LED_LINK: J6.10 (CATHODE), U32.22 (LED_LINK/AN0)
LED_SPEED: J6.12 (CATHODE), U32.21 (LED_SPEED/AN1)
unnamed: C2.1, U32.16 (PFBIN1)
unnamed: C62.1, U32.30 (PFBIN2)
unnamed: C66.1, C67.1, U32.19 (PFBOUT)
unnamed: J6.9 (ANODE), R10.1
unnamed: J6.11 (ANODE), R9.1
unnamed: R88.1, U32.20 (RBIAS)
unnamed: R90.2, U32.32 (RX_DV/MII_MODE)
RD_N: J6.6 (RD-), R93.2, U32.11 (RD-)
RD_P: J6.3 (RD+), R94.1, U32.12 (RD+)
RMII_CRS_DV: U32.33 (CRS/CRS_DV/LED_CFG)
RMII_RXD0: U32.36 (RXD_0/PHYAD1)
RMII_RXD1: U32.37 (RXD_1/PHYAD2)
RMII_TXD0: U32.4 (TXD_0)
RMII_TXD1: U32.5 (TXD_1)
RMII_TXEN: U32.3 (TX_EN)
TD_N: J6.2 (TD-), R91.2, U32.14 (TD-)
TD_P: J6.1 (TD+), R92.1, U32.15 (TD+)

Notes on the sheet:
This way we strap AN pins to 11
TPTDP = TD+ TPTDM = TD- TPRDP = RD+ TPRDM = RD-
The magnetics are integrated in the connector. We need to add some extra components though, from page 65 in the DP83848 Datasheet
In this device, left LED is green and right LED is orange. We use left (pin 9, 10) for LINK, and right (11, 12) for SPEED.
