aesirkth/surtr-hardware/hss12.kicad_sch

## KiCad design hss12.kicad_sch (2024-04-28)

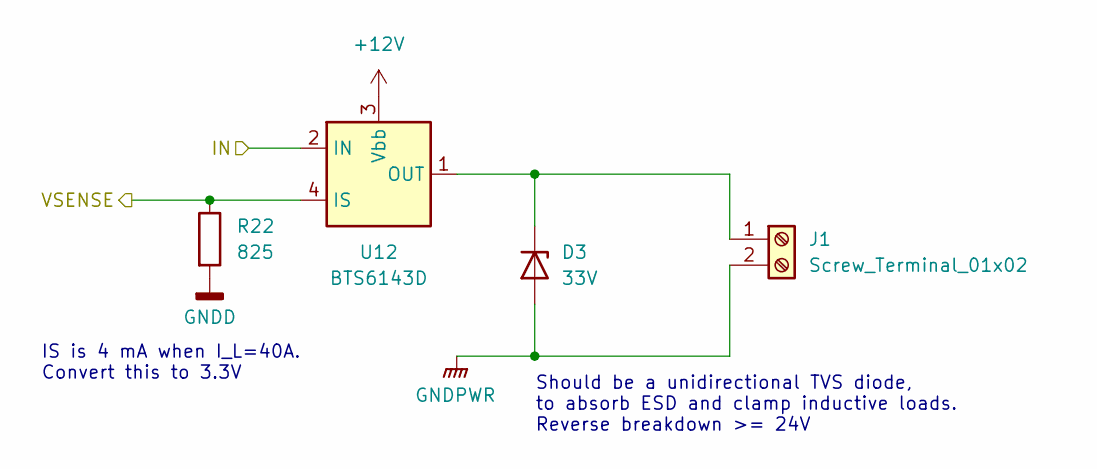
[picture p46: schematic hss12.kicad_sch]

Parts:
D3: 33V
J1: Screw_Terminal_01x02
R22: 825
U12: BTS6143D; TO-252-4

Connections:
+12V: U12.3 (Vbb)
GNDD: R22.2
GNDPWR: D3.2 (A), J1.2
IN: U12.2 (IN)
unnamed: D3.1 (K), J1.1, U12.1 (OUT), U12.5 (OUT)
VSENSE: R22.1, U12.4 (IS)

Notes on the sheet:
IS is 4 mA when I_L=40A. Convert this to 3.3V
Should be a unidirectional TVS diode, to absorb ESD and clamp inductive loads. Reverse breakdown >= 24V
