aesirkth/surtr-hardware/hss24.kicad_sch

## KiCad design hss24.kicad_sch (2024-04-28)

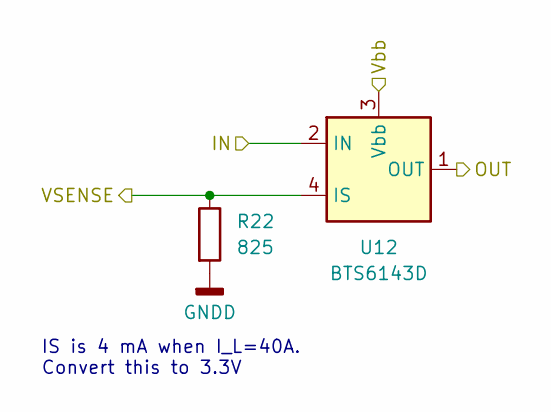
[picture p47: schematic hss24.kicad_sch]

Parts:
R22: 825
U12: BTS6143D; TO-252-4

Connections:
GNDD: R22.2
IN: U12.2 (IN)
OUT: U12.1 (OUT), U12.5 (OUT)
VSENSE: R22.1, U12.4 (IS)
Vbb: U12.3 (Vbb)

Notes on the sheet:
IS is 4 mA when I_L=40A. Convert this to 3.3V
