aesirkth/surtr-hardware/hss.kicad_sch

## KiCad design hss.kicad_sch (2024-05-01)

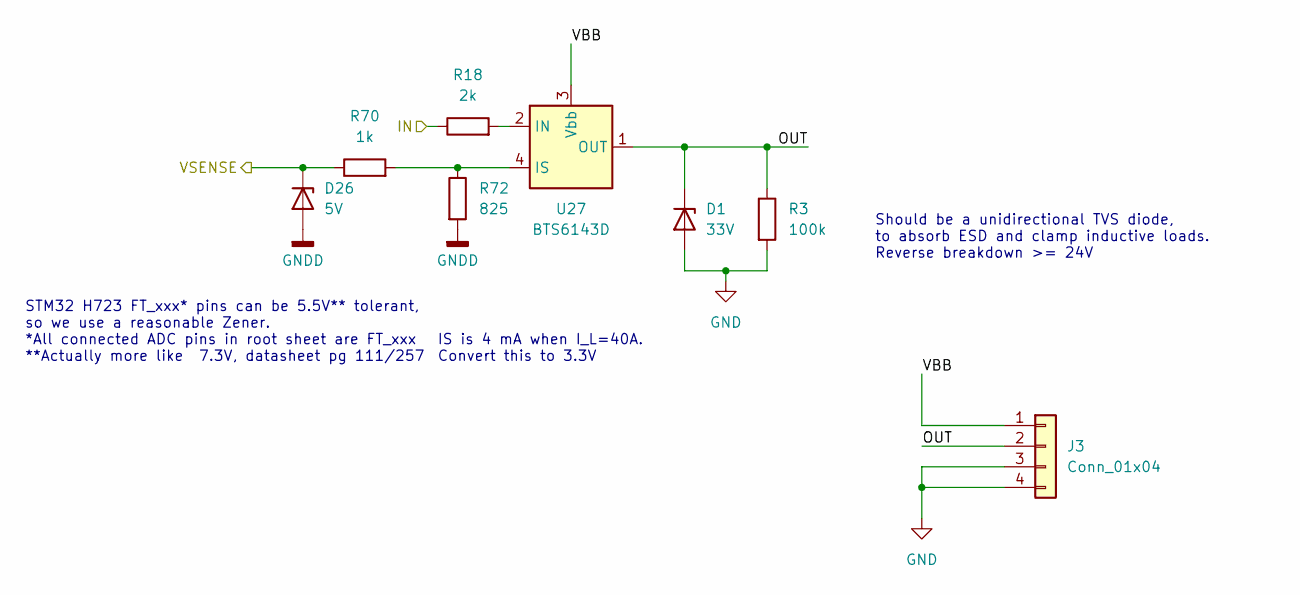
[picture p48: schematic hss.kicad_sch]

Parts:
D1: 33V; D_0805_2012Metric_Pad1.15x1.40mm_HandSolder; Mouser# 821-BZY55C33RBG
D26: 5V; SOT-23_Handsoldering; Mouser# 771-PLVA650A-QR
J3: Conn_01x04; PhoenixContact_MSTBA_2,5_4-G-5,08_1x04_P5.08mm_Horizontal; Mouser# 651-1757268
R3: 100k; R_0603_1608Metric_Pad0.98x0.95mm_HandSolder
R18: 2k; R_0603_1608Metric_Pad0.98x0.95mm_HandSolder
R70: 1k; R_0603_1608Metric_Pad0.98x0.95mm_HandSolder
R72: 825; R_0603_1608Metric_Pad0.98x0.95mm_HandSolder
U27: BTS6143D; TO-252-4

Connections:
GND: D1.2 (A), J3.3, J3.4, R3.2
GNDD: D26.2 (A), R72.2
IN: R18.1
unnamed: R18.2, U27.2 (IN)
unnamed: R70.2, R72.1, U27.4 (IS)
OUT: D1.1 (K), J3.2, R3.1, U27.1 (OUT), U27.5 (OUT)
VBB: J3.1, U27.3 (Vbb)
VSENSE: D26.1 (K), R70.1

Notes on the sheet:
IS is 4 mA when I_L=40A. Convert this to 3.3V
STM32 H723 FT_xxx* pins can be 5.5V** tolerant, so we use a reasonable Zener. *All connected ADC pins in root sheet are FT_xxx **Actually more like 7.3V, datasheet pg 111/257
Should be a unidirectional TVS diode, to absorb ESD and clamp inductive loads. Reverse breakdown >= 24V
