aesirkth/surtr-hardware/ina260sense.kicad_sch

## KiCad design ina260sense.kicad_sch (2024-05-01)

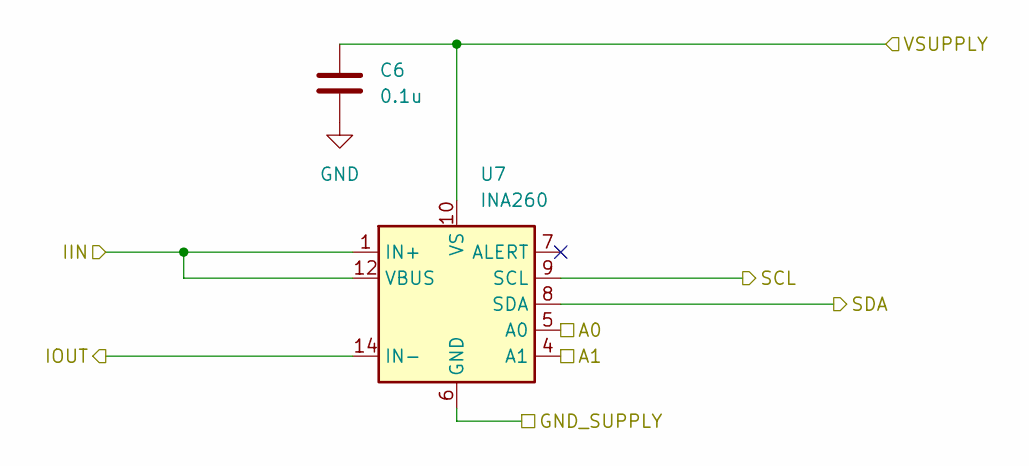
[picture p49: schematic ina260sense.kicad_sch]

Parts:
C6: 0.1u; C_0603_1608Metric_Pad1.08x0.95mm_HandSolder
U7: INA260; TSSOP-16_4.4x5mm_P0.65mm

Connections:
A0: U7.5 (A0)
A1: U7.4 (A1)
GND: C6.2
GND_SUPPLY: U7.6 (GND), U7.11 (GND)
IIN: U7.1 (IN+), U7.2 (IN+), U7.3 (IN+), U7.12 (VBUS)
IOUT: U7.14 (IN-), U7.15 (IN-), U7.16 (IN-)
SCL: U7.9 (SCL)
SDA: U7.8 (SDA)
VSUPPLY: C6.1, U7.10 (VS)
