aesirkth/surtr-hardware/launchpad-controller-v2.kicad_sch

## KiCad design launchpad-controller-v2.kicad_sch (2024-05-02)

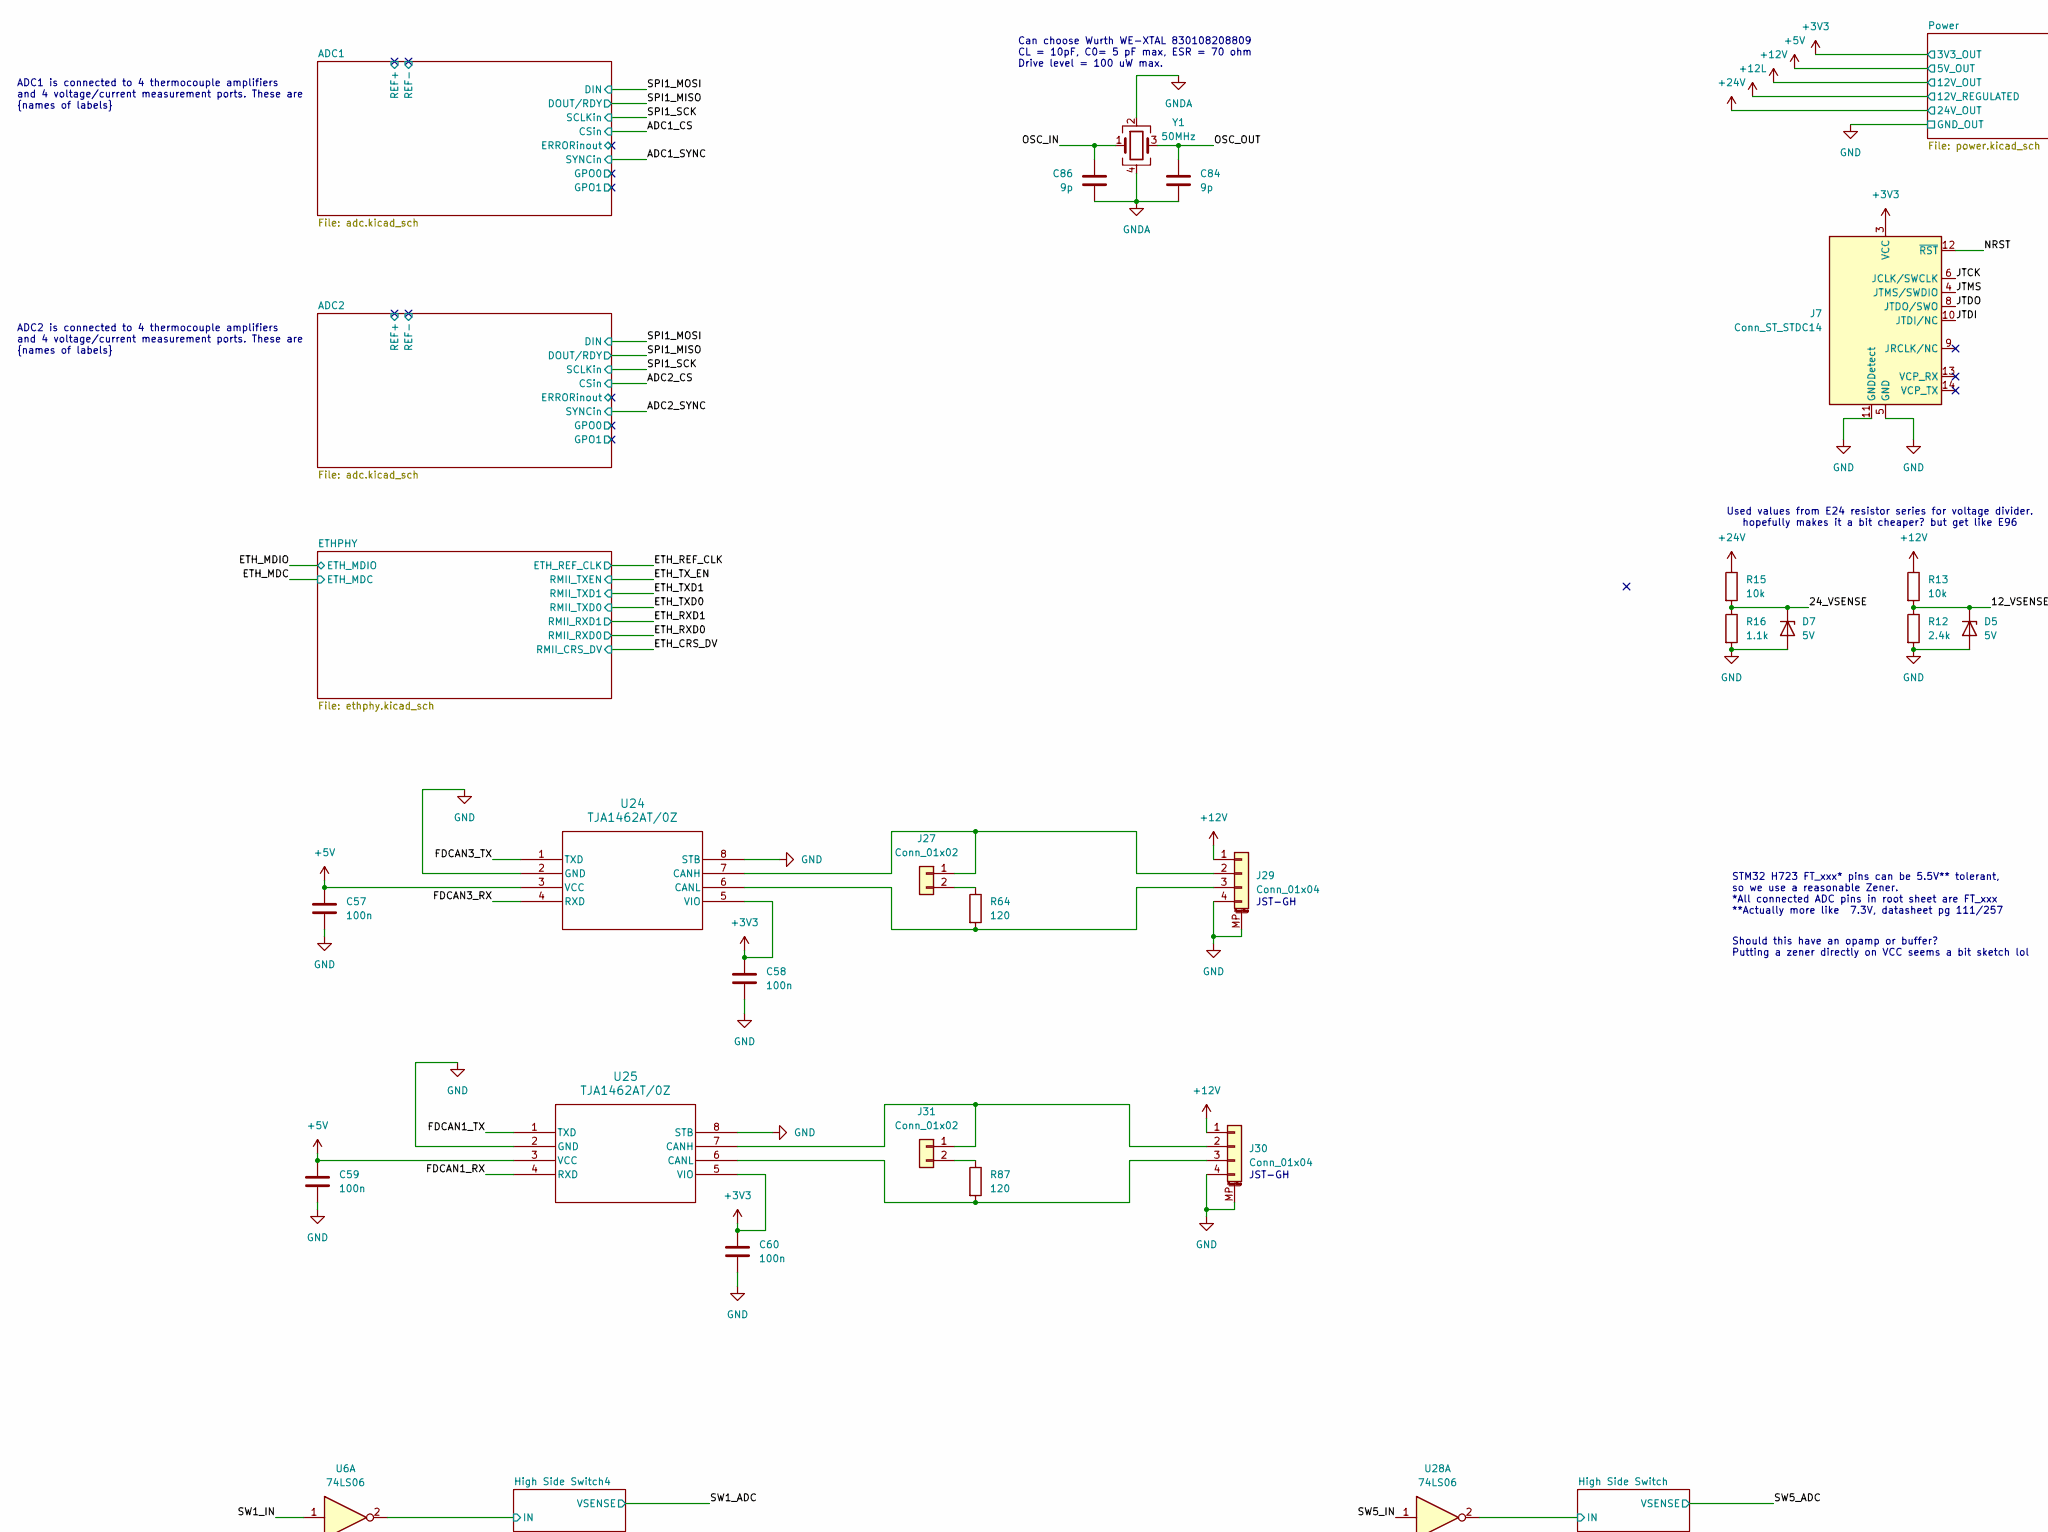
[picture p50: schematic launchpad-controller-v2.kicad_sch, part in row 1, column 1]

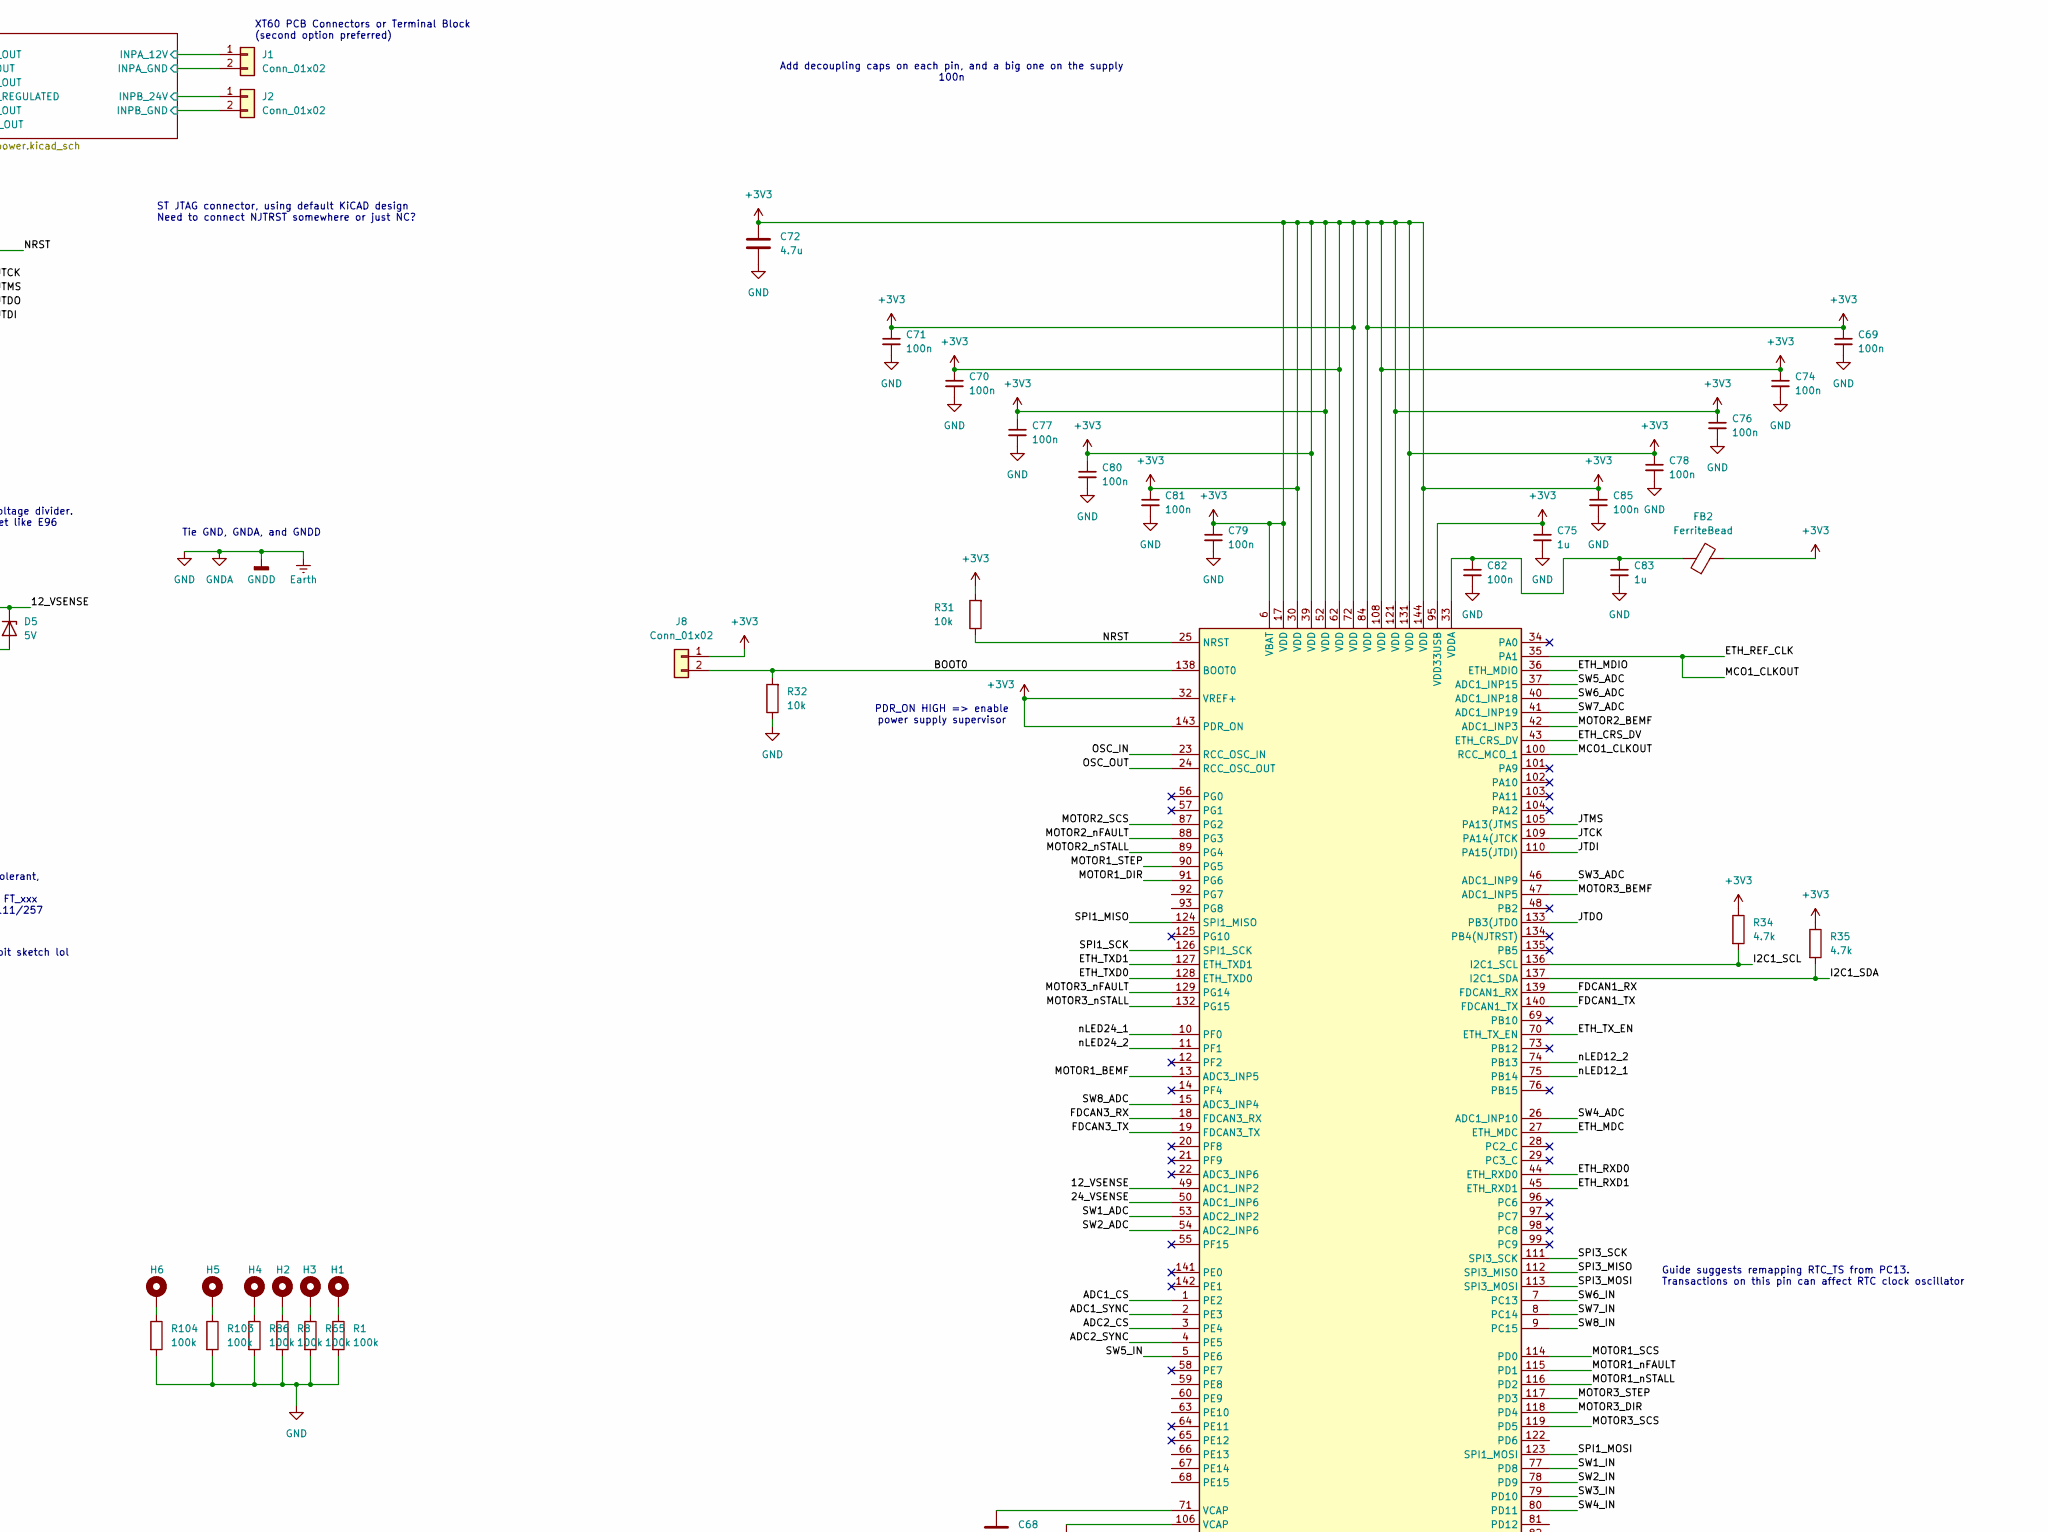
[picture p51: schematic launchpad-controller-v2.kicad_sch, part in row 1, column 2]

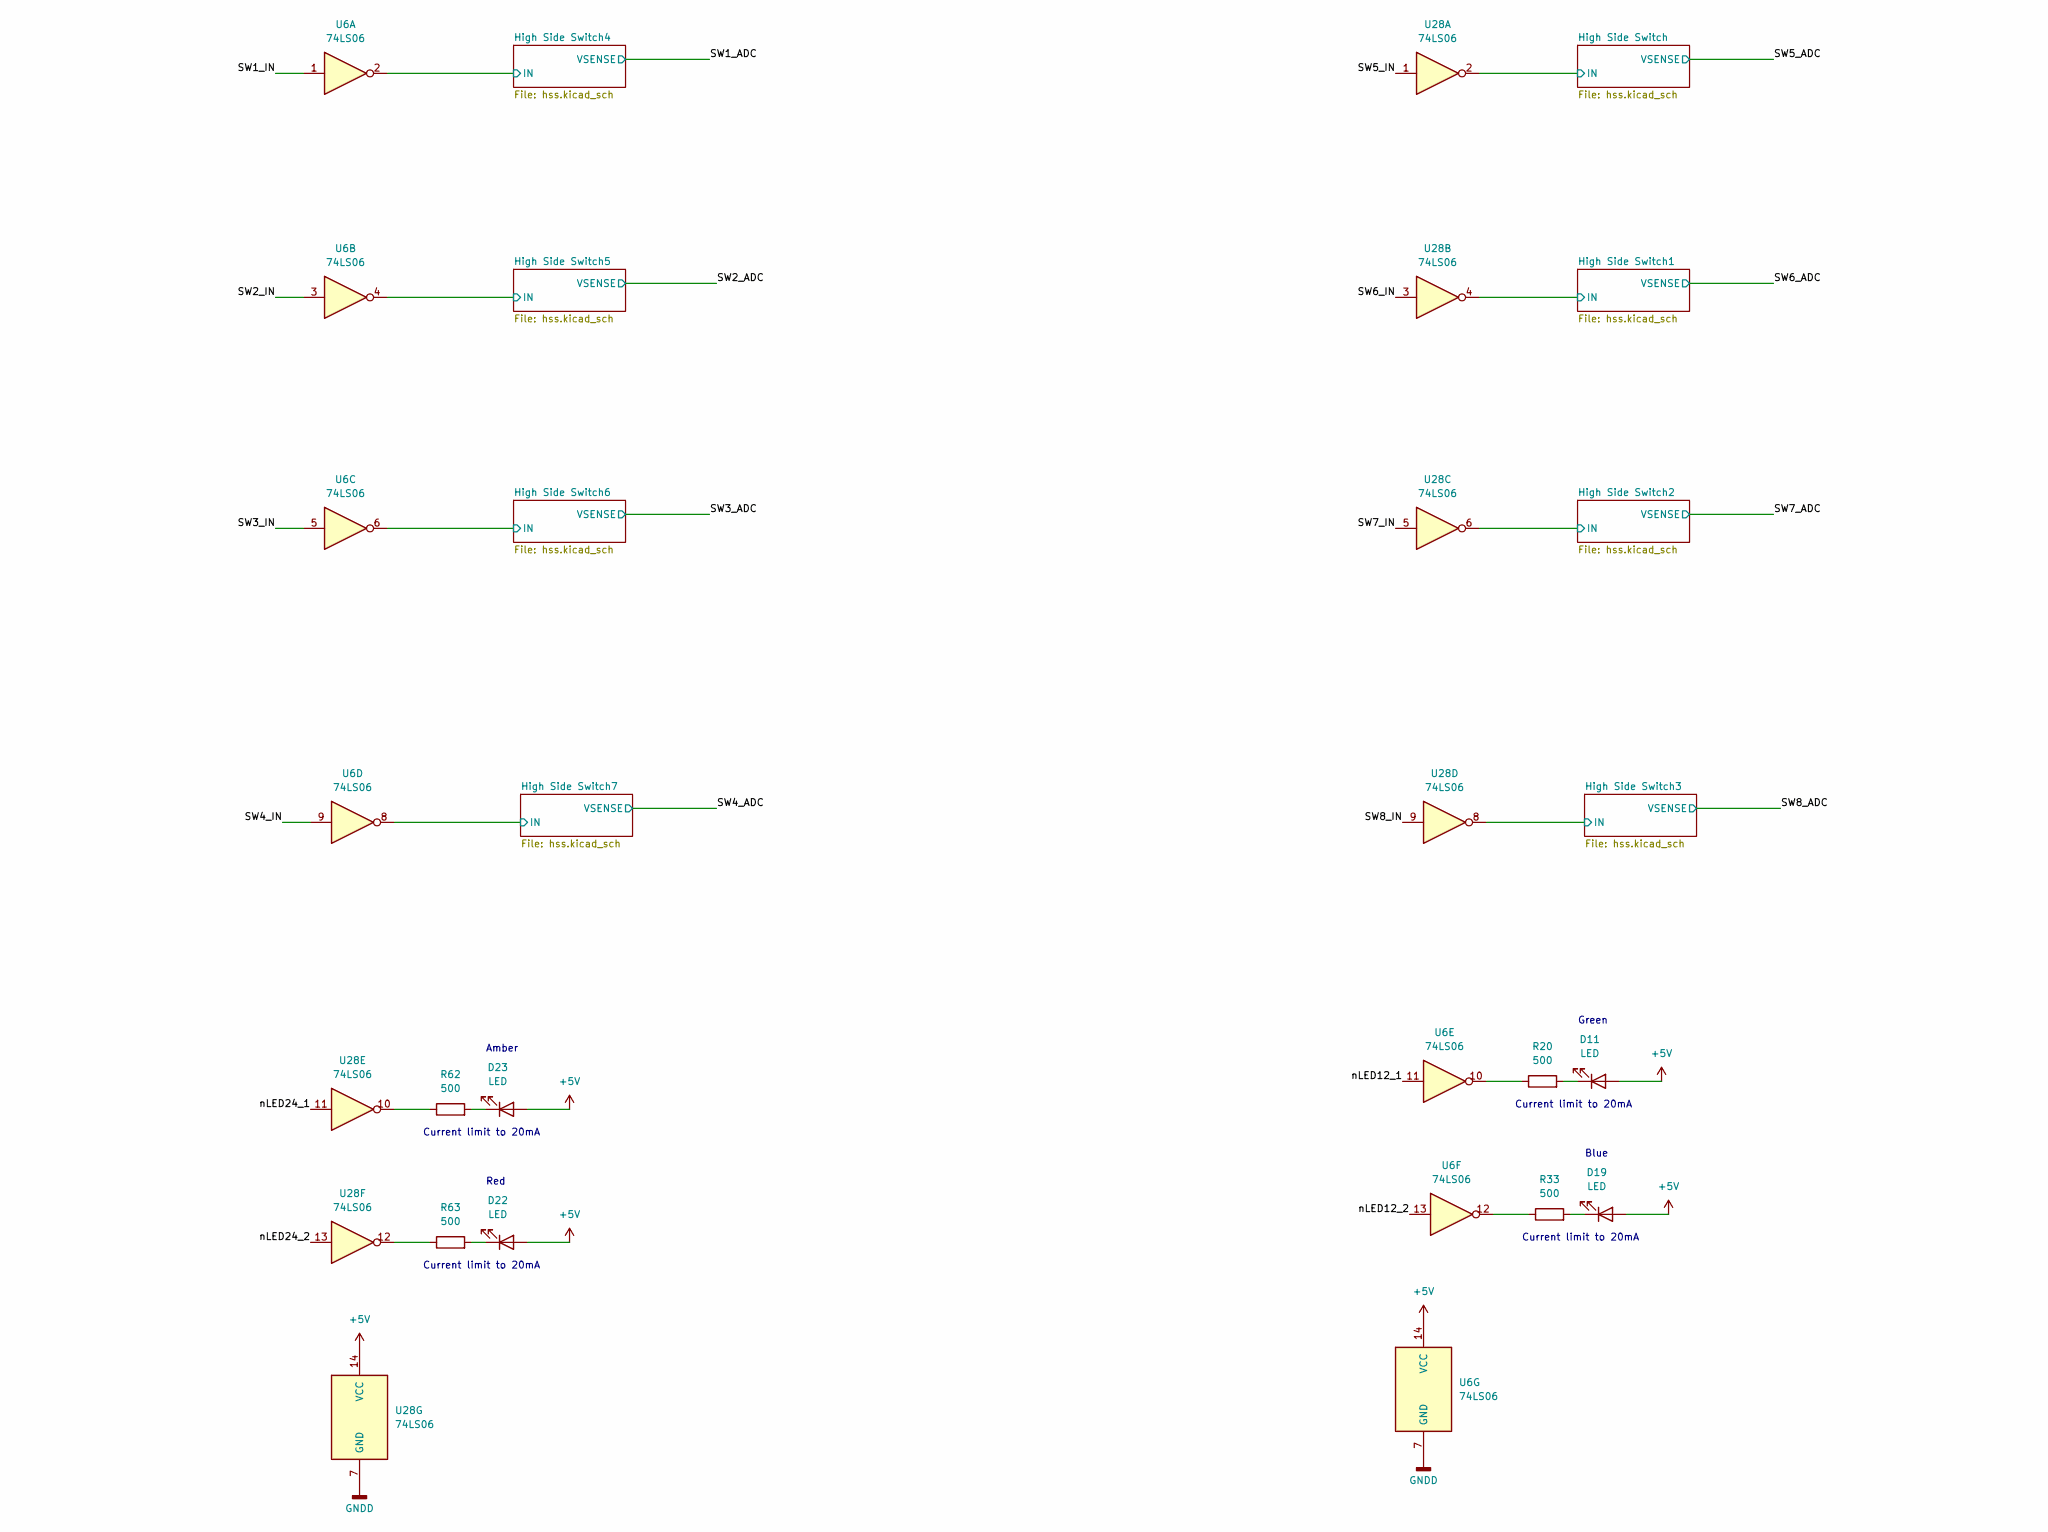
[picture p52: schematic launchpad-controller-v2.kicad_sch, part in row 2, column 1]

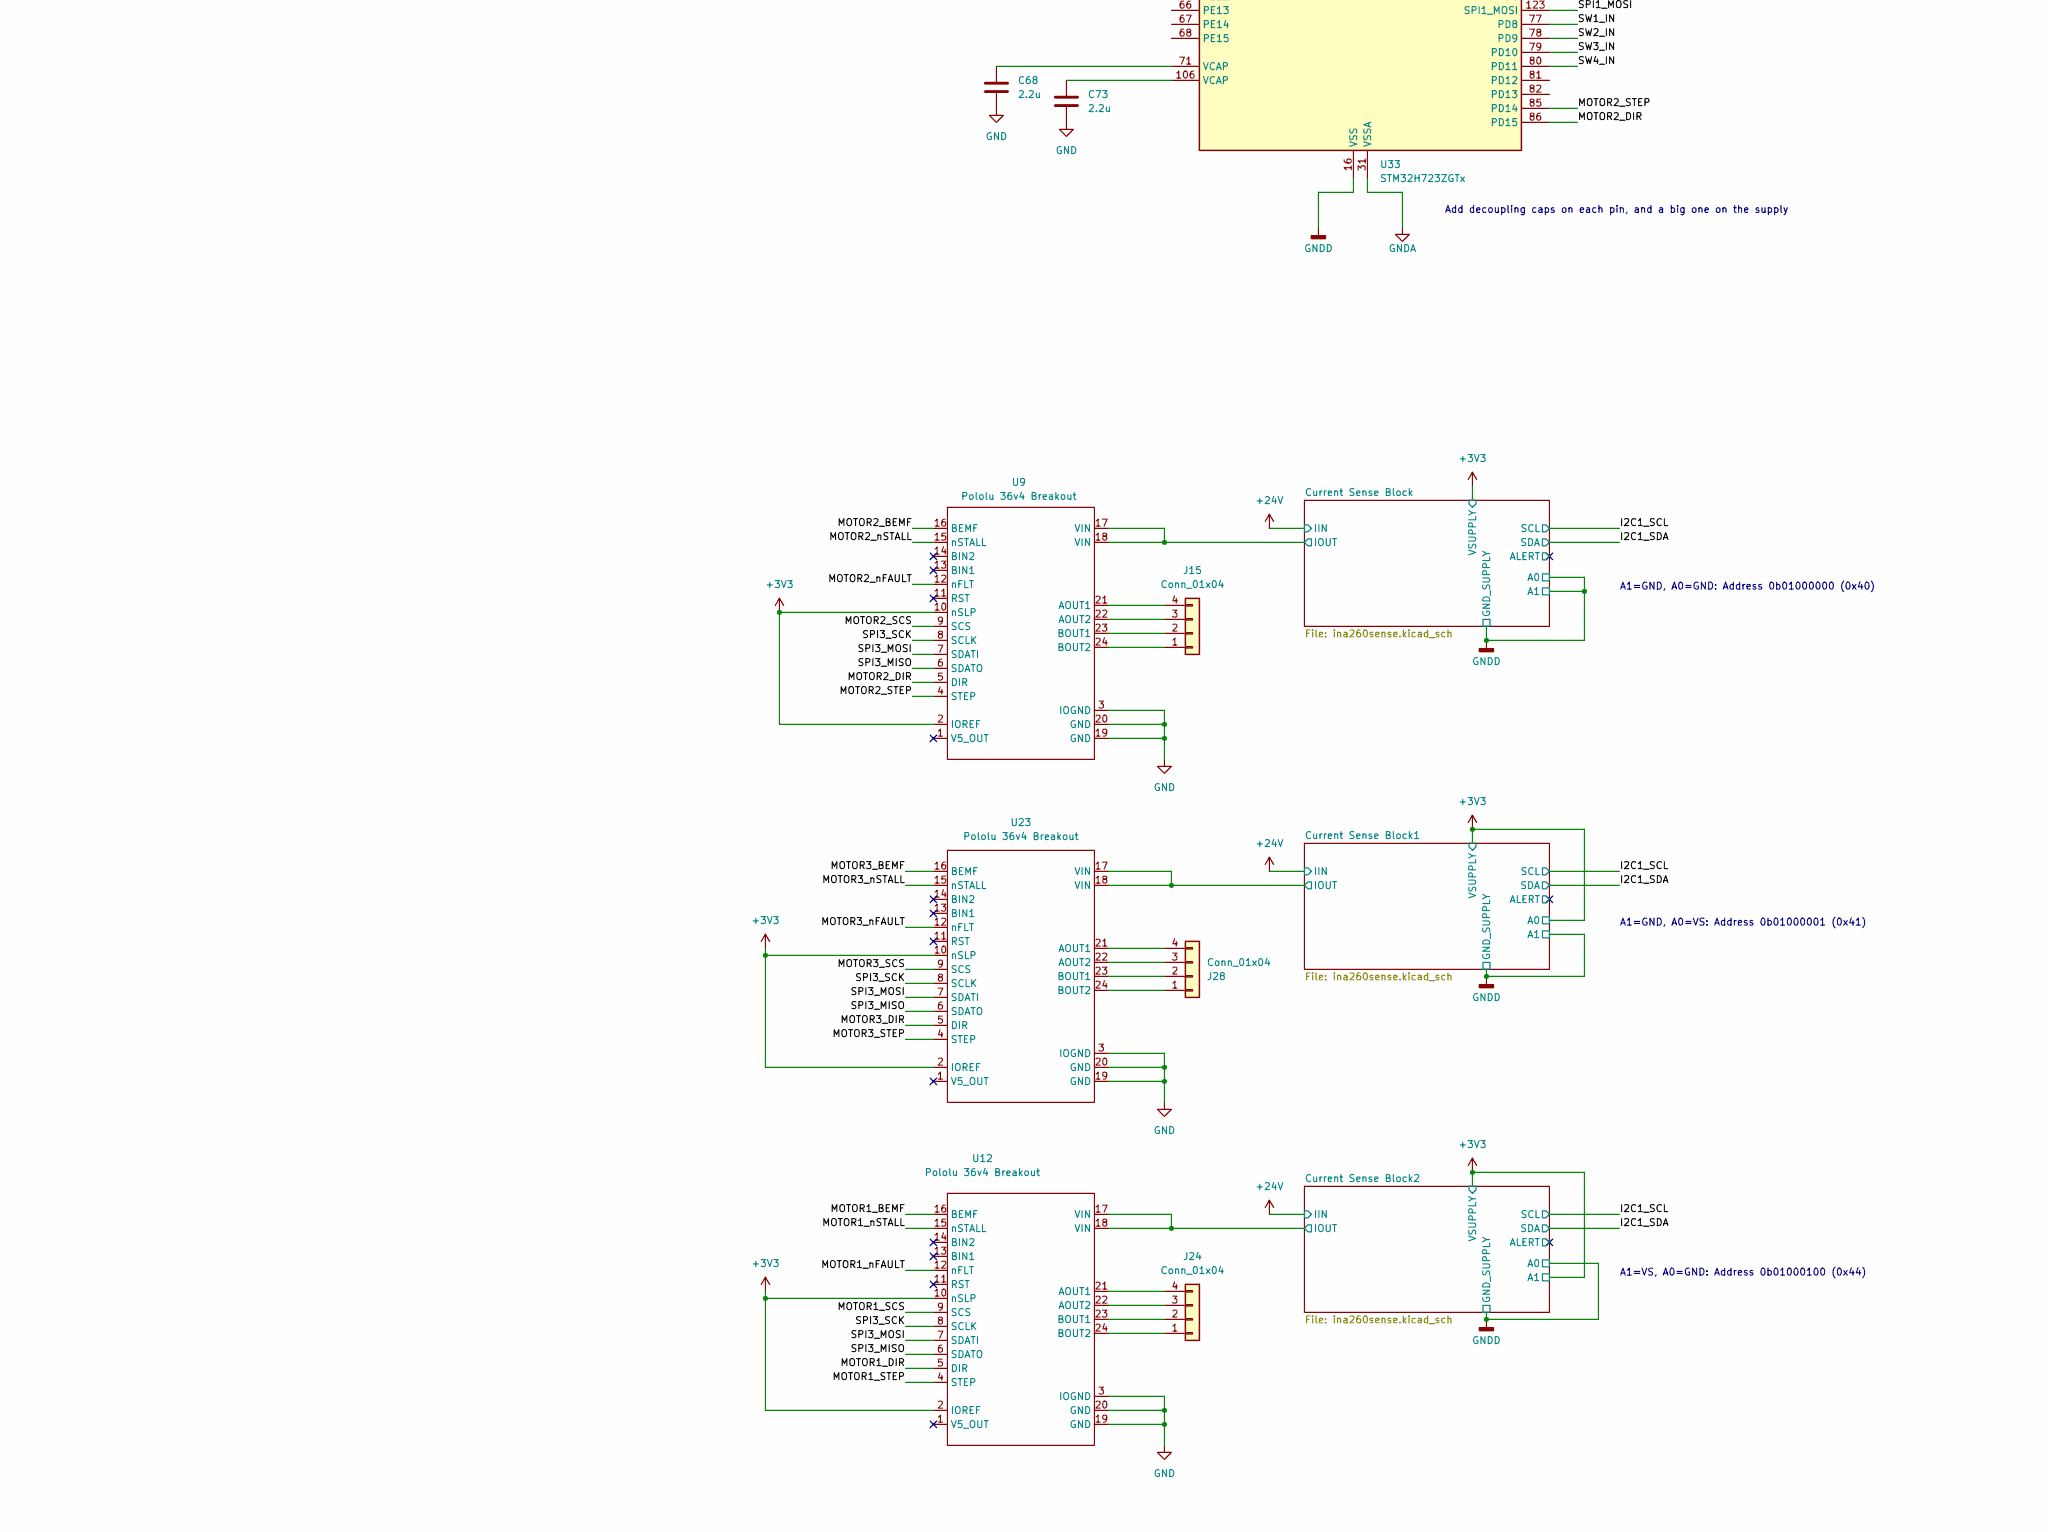
[picture p53: schematic launchpad-controller-v2.kicad_sch, part in row 2, column 2]

Parts:
C57, C58, C59, C60, C69, C70, C71, C74, C76, C77, C78, C79, C80, C81, C82, C85: 100n; C_0603_1608Metric_Pad1.08x0.95mm_HandSolder
C68, C73: 2.2u; C_0603_1608Metric_Pad1.08x0.95mm_HandSolder
C72: 4.7u; C_0603_1608Metric_Pad1.08x0.95mm_HandSolder
C75, C83: 1u; C_0603_1608Metric_Pad1.08x0.95mm_HandSolder
C84, C86: 9p; C_0603_1608Metric_Pad1.08x0.95mm_HandSolder
D5, D7: 5V; SOT-23_Handsoldering; Mouser# 771-PLVA650A-QR
D11, D19, D22, D23: LED; LED_0805_2012Metric_Pad1.15x1.40mm_HandSolder
FB2: FerriteBead; L_0805_2012Metric_Pad1.15x1.40mm_HandSolder; Mouser# 81-BLM18KG102SN1D
H1, H2, H3, H4, H5, H6: MountingHole_Pad; MountingHole_4.3mm_M4_Pad_Via
J1, J2: Conn_01x02; PhoenixContact_MSTBA_2,5_2-G-5,08_1x02_P5.08mm_Horizontal
J7: Conn_ST_STDC14; PinHeader_2x07_P1.27mm_Vertical_SMD
J8, J27, J31: Conn_01x02; PinHeader_1x02_P2.54mm_Vertical
J15, J24, J28: Conn_01x04; PhoenixContact_MSTBA_2,5_4-G-5,08_1x04_P5.08mm_Horizontal; Mouser# 651-1757268
J29, J30: Conn_01x04; JST_GH_BM04B-GHS-TBT_1x04-1MP_P1.25mm_Vertical
R1, R8, R65, R86, R103, R104: 100k; R_0603_1608Metric_Pad0.98x0.95mm_HandSolder
R12: 2.4k; R_0603_1608Metric_Pad0.98x0.95mm_HandSolder
R13, R15, R31, R32: 10k; R_0603_1608Metric_Pad0.98x0.95mm_HandSolder
R16: 1.1k; R_0603_1608Metric_Pad0.98x0.95mm_HandSolder
R20, R33, R62, R63: 500; R_0603_1608Metric_Pad0.98x0.95mm_HandSolder
R34, R35: 4.7k; R_0603_1608Metric_Pad0.98x0.95mm_HandSolder
R64, R87: 120; R_0603_1608Metric_Pad0.98x0.95mm_HandSolder
U6, U28: 74LS06; SOIC-14_3.9x8.7mm_P1.27mm; Mouser# 595-SN74LS06NSRG4
U9, U12, U23: Pololu 36v4 Breakout; pololu
U24, U25: TJA1462AT/0Z; SO8_SOT96-1_NXP
U33: STM32H723ZGTx; LQFP-144_20x20mm_P0.5mm
Y1: 50MHz; Crystal_SMD_EuroQuartz_X22-4Pin_2.5x2.0mm_HandSoldering

Connections:
12_VSENSE: D5.1 (K), R12.1, R13.2, U33.49 (PF11)
24_VSENSE: D7.1 (K), R15.2, R16.1, U33.50 (PF12)
+3V3: C58.1, C60.1, C69.1, C70.1, C71.1, C72.1, C74.1, C75.1, C76.1, C77.1, C78.1, C79.1, C80.1, C81.1, C85.1, FB2.2, J7.3 (VCC), J8.1, R31.2, R34.1, R35.1, U9.2 (IOREF), U9.10 (nSLP), U12.2 (IOREF), U12.10 (nSLP), U23.2 (IOREF), U23.10 (nSLP), U24.5 (VIO), U25.5 (VIO), U33.6 (VBAT), U33.17 (VDD), U33.30 (VDD), U33.32 (VREF+), U33.39 (VDD), U33.52 (VDD), U33.62 (VDD), U33.72 (VDD), U33.84 (VDD), U33.95 (VDD33USB), U33.108 (VDD), U33.121 (VDD), U33.131 (VDD), U33.143 (PDR_ON), U33.144 (VDD)
+5V: C57.1, C59.1, D11.2 (A), D19.2 (A), D22.2 (A), D23.2 (A), U6.14 (VCC), U24.3 (VCC), U25.3 (VCC), U28.14 (VCC)
+12V: J29.1, J30.1, R13.1
+24V: R15.1
ADC1_CS: U33.1 (PE2)
ADC1_SYNC: U33.2 (PE3)
ADC2_CS: U33.3 (PE4)
ADC2_SYNC: U33.4 (PE5)
BOOT0: J8.2, R32.2, U33.138 (BOOT0)
ETH_CRS_DV: U33.43 (PA7)
ETH_MDC: U33.27 (PC1)
ETH_MDIO: U33.36 (PA2)
ETH_REF_CLK: U33.35 (PA1), U33.100 (PA8)
ETH_RXD0: U33.44 (PC4)
ETH_RXD1: U33.45 (PC5)
ETH_TXD0: U33.128 (PG13)
ETH_TXD1: U33.127 (PG12)
ETH_TX_EN: U33.70 (PB11)
Earth: C57.2, C58.2, C59.2, C60.2, C68.2, C69.2, C70.2, C71.2, C72.2, C73.2, C74.2, C75.2, C76.2, C77.2, C78.2, C79.2, C80.2, C81.2, C82.2, C83.2, C84.2, C85.2, C86.2, D5.2 (A), D7.2 (A), J7.5 (GND), J7.7 (GND), J7.11 (GNDDetect), J29.4, J29.MP (MountPin), J30.4, J30.MP (MountPin), R1.2, R8.2, R12.2, R16.2, R32.1, R65.2, R86.2, R103.2, R104.2, U6.7 (GND), U9.3 (IOGND), U9.19 (GND), U9.20 (GND), U12.3 (IOGND), U12.19 (GND), U12.20 (GND), U23.3 (IOGND), U23.19 (GND), U23.20 (GND), U24.2 (GND), U24.8 (STB), U25.2 (GND), U25.8 (STB), U28.7 (GND), U33.16 (VSS), U33.31 (VSSA), U33.38 (VSS), U33.51 (VSS), U33.61 (VSS), U33.83 (VSS), U33.94 (VSS), U33.107 (VSS), U33.120 (VSS), U33.130 (VSS), Y1.2, Y1.4
FDCAN1_RX: U25.4 (RXD), U33.139 (PB8)
FDCAN1_TX: U25.1 (TXD), U33.140 (PB9)
FDCAN3_RX: U24.4 (RXD), U33.18 (PF6)
FDCAN3_TX: U24.1 (TXD), U33.19 (PF7)
I2C1_SCL: R34.2, U33.136 (PB6)
I2C1_SDA: R35.2, U33.137 (PB7)
IN: U6.2, U6.4, U6.6, U6.8, U28.2, U28.4, U28.6, U28.8
INPA_12V: J1.1
INPA_GND: J1.2
INPB_24V: J2.1
INPB_GND: J2.2
IOUT: U9.17 (VIN), U9.18 (VIN), U12.17 (VIN), U12.18 (VIN), U23.17 (VIN), U23.18 (VIN)
JTCK: J7.6 (JCLK/SWCLK), U33.109 (PA14(JTCK)
JTDI: J7.10 (JTDI/NC), U33.110 (PA15(JTDI))
JTDO: J7.8 (JTDO/SWO), U33.133 (PB3(JTDO)
JTMS: J7.4 (JTMS/SWDIO), U33.105 (PA13(JTMS)
MOTOR1_BEMF: U12.16 (BEMF), U33.13 (PF3)
MOTOR1_DIR: U12.5 (DIR), U33.91 (PG6)
MOTOR1_SCS: U12.9 (SCS), U33.114 (PD0)
MOTOR1_STEP: U12.4 (STEP), U33.90 (PG5)
MOTOR1_nFAULT: U12.12 (nFLT), U33.115 (PD1)
MOTOR1_nSTALL: U12.15 (nSTALL), U33.116 (PD2)
MOTOR2_BEMF: U9.16 (BEMF), U33.42 (PA6)
MOTOR2_DIR: U9.5 (DIR), U33.86 (PD15)
MOTOR2_SCS: U9.9 (SCS), U33.87 (PG2)
MOTOR2_STEP: U9.4 (STEP), U33.85 (PD14)
MOTOR2_nFAULT: U9.12 (nFLT), U33.88 (PG3)
MOTOR2_nSTALL: U9.15 (nSTALL), U33.89 (PG4)
MOTOR3_BEMF: U23.16 (BEMF), U33.47 (PB1)
MOTOR3_DIR: U23.5 (DIR), U33.118 (PD4)
MOTOR3_SCS: U23.9 (SCS), U33.119 (PD5)
MOTOR3_STEP: U23.4 (STEP), U33.117 (PD3)
MOTOR3_nFAULT: U23.12 (nFLT), U33.129 (PG14)
MOTOR3_nSTALL: U23.15 (nSTALL), U33.132 (PG15)
NRST: J7.12 (~RST), R31.1, U33.25 (NRST)
unnamed: C68.1, U33.71 (VCAP)
unnamed: C73.1, U33.106 (VCAP)
unnamed: C82.1, C83.1, FB2.1, U33.33 (VDDA)
unnamed: D11.1 (K), R20.2
unnamed: D19.1 (K), R33.2
unnamed: D22.1 (K), R63.2
unnamed: D23.1 (K), R62.2
unnamed: H1.1, R1.1
unnamed: H2.1, R8.1
unnamed: H3.1, R65.1
unnamed: H4.1, R86.1
unnamed: H5.1, R103.1
unnamed: H6.1, R104.1
unnamed: J15.1, U9.24 (BOUT2)
unnamed: J15.2, U9.23 (BOUT1)
unnamed: J15.3, U9.22 (AOUT2)
unnamed: J15.4, U9.21 (AOUT1)
unnamed: J24.1, U12.24 (BOUT2)
unnamed: J24.2, U12.23 (BOUT1)
unnamed: J24.3, U12.22 (AOUT2)
unnamed: J24.4, U12.21 (AOUT1)
unnamed: J27.1, J29.2, U24.7 (CANH)
unnamed: J27.2, R64.1
unnamed: J28.1, U23.24 (BOUT2)
unnamed: J28.2, U23.23 (BOUT1)
unnamed: J28.3, U23.22 (AOUT2)
unnamed: J28.4, U23.21 (AOUT1)
unnamed: J29.3, R64.2, U24.6 (CANL)
unnamed: J30.2, J31.1, U25.7 (CANH)
unnamed: J30.3, R87.2, U25.6 (CANL)
unnamed: J31.2, R87.1
unnamed: R20.1, U6.10
unnamed: R33.1, U6.12
unnamed: R62.1, U28.10
unnamed: R63.1, U28.12
OSC_IN: C86.1, U33.23 (PH0), Y1.1
OSC_OUT: C84.1, U33.24 (PH1), Y1.3
SPI1_MISO: U33.124 (PG9)
SPI1_MOSI: U33.123 (PD7)
SPI1_SCK: U33.126 (PG11)
SPI3_MISO: U9.6 (SDATO), U12.6 (SDATO), U23.6 (SDATO), U33.112 (PC11)
SPI3_MOSI: U9.7 (SDATI), U12.7 (SDATI), U23.7 (SDATI), U33.113 (PC12)
SPI3_SCK: U9.8 (SCLK), U12.8 (SCLK), U23.8 (SCLK), U33.111 (PC10)
SW1_ADC: U33.53 (PF13)
SW1_IN: U6.1, U33.77 (PD8)
SW2_ADC: U33.54 (PF14)
SW2_IN: U6.3, U33.78 (PD9)
SW3_ADC: U33.46 (PB0)
SW3_IN: U6.5, U33.79 (PD10)
SW4_ADC: U33.26 (PC0)
SW4_IN: U6.9, U33.80 (PD11)
SW5_ADC: U33.37 (PA3)
SW5_IN: U28.1, U33.5 (PE6)
SW6_ADC: U33.40 (PA4)
SW6_IN: U28.3, U33.7 (PC13)
SW7_ADC: U33.41 (PA5)
SW7_IN: U28.5, U33.8 (PC14)
SW8_ADC: U33.15 (PF5)
SW8_IN: U28.9, U33.9 (PC15)
nLED12_1: U6.11, U33.75 (PB14)
nLED12_2: U6.13, U33.74 (PB13)
nLED24_1: U28.11, U33.10 (PF0)
nLED24_2: U28.13, U33.11 (PF1)

Notes on the sheet:
A1=VS, A0=GND: Address 0b01000100 (0x44)
A1=GND, A0=GND: Address 0b01000000 (0x40)
ST JTAG connector, using default KiCAD design Need to connect NJTRST somewhere or just NC?
Can choose Wurth WE-XTAL 830108208809 CL = 10pF, C0= 5 pF max, ESR = 70 ohm Drive level = 100 uW max.
PDR_ON HIGH => enable power supply supervisor
Tie GND, GNDA, and GNDD
Green
Should this have an opamp or buffer? Putting a zener directly on VCC seems a bit sketch lol
ADC1 is connected to 4 thermocouple amplifiers and 4 voltage/current measurement ports. These are {names of labels}
Amber
ADC2 is connected to 4 thermocouple amplifiers and 4 voltage/current measurement ports. These are {names of labels}
Used values from E24 resistor series for voltage divider. hopefully makes it a bit cheaper? but get like E96
Current limit to 20mA
Red
Add decoupling caps on each pin, and a big one on the supply
STM32 H723 FT_xxx* pins can be 5.5V** tolerant, so we use a reasonable Zener. *All connected ADC pins in root sheet are FT_xxx **Actually more like 7.3V, datasheet pg 111/257
JST-GH
XT60 PCB Connectors or Terminal Block (second option preferred)
Blue
Add decoupling caps on each pin, and a big one on the supply 100n
A1=GND, A0=VS: Address 0b01000001 (0x41)
Guide suggests remapping RTC_TS from PC13. Transactions on this pin can affect RTC clock oscillator
