aesirkth/surtr-hardware/pololu_36v4_breakout.kicad_sch

## KiCad design pololu_36v4_breakout.kicad_sch (2024-04-28)

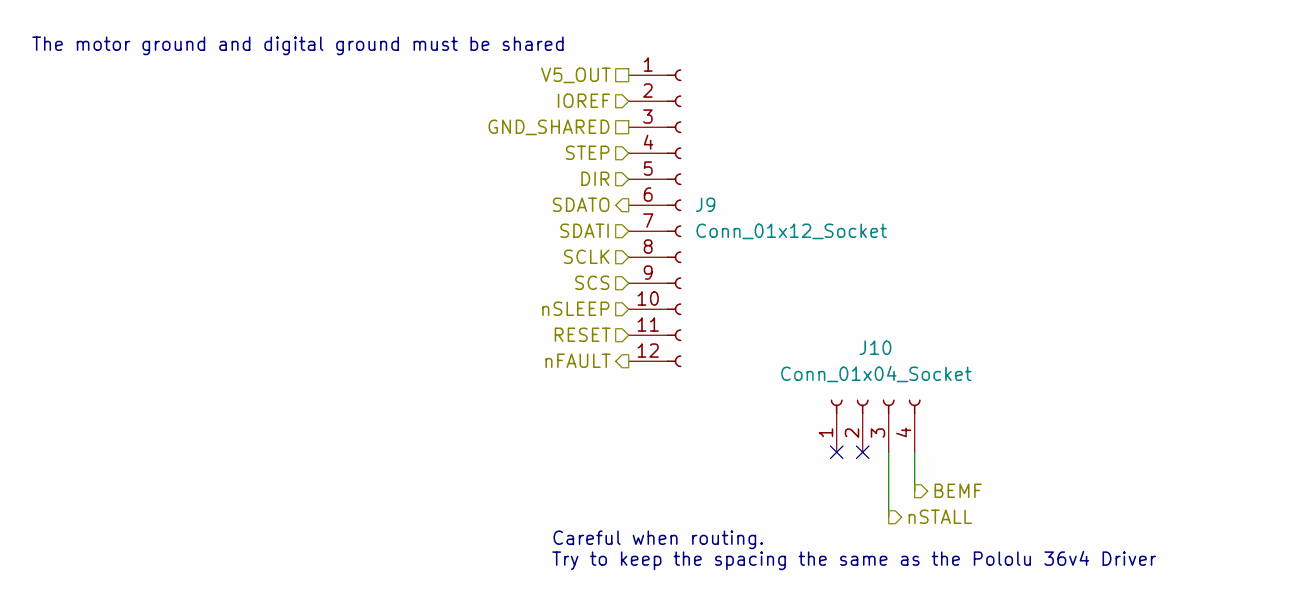
[picture p54: schematic pololu_36v4_breakout.kicad_sch]

Parts:
J9: Conn_01x12_Socket; PinSocket_1x12_P2.54mm_Vertical
J10: Conn_01x04_Socket; PinSocket_1x04_P2.54mm_Vertical

Connections:
BEMF: J10.4
DIR: J9.5
GND_SHARED: J9.3
IOREF: J9.2
RESET: J9.11
SCLK: J9.8
SCS: J9.9
SDATI: J9.7
SDATO: J9.6
STEP: J9.4
V5_OUT: J9.1
nFAULT: J9.12
nSLEEP: J9.10
nSTALL: J10.3

Notes on the sheet:
Careful when routing. Try to keep the spacing the same as the Pololu 36v4 Driver
The motor ground and digital ground must be shared
