aesirkth/surtr-hardware/power.kicad_sch

## KiCad design power.kicad_sch (2024-05-01)

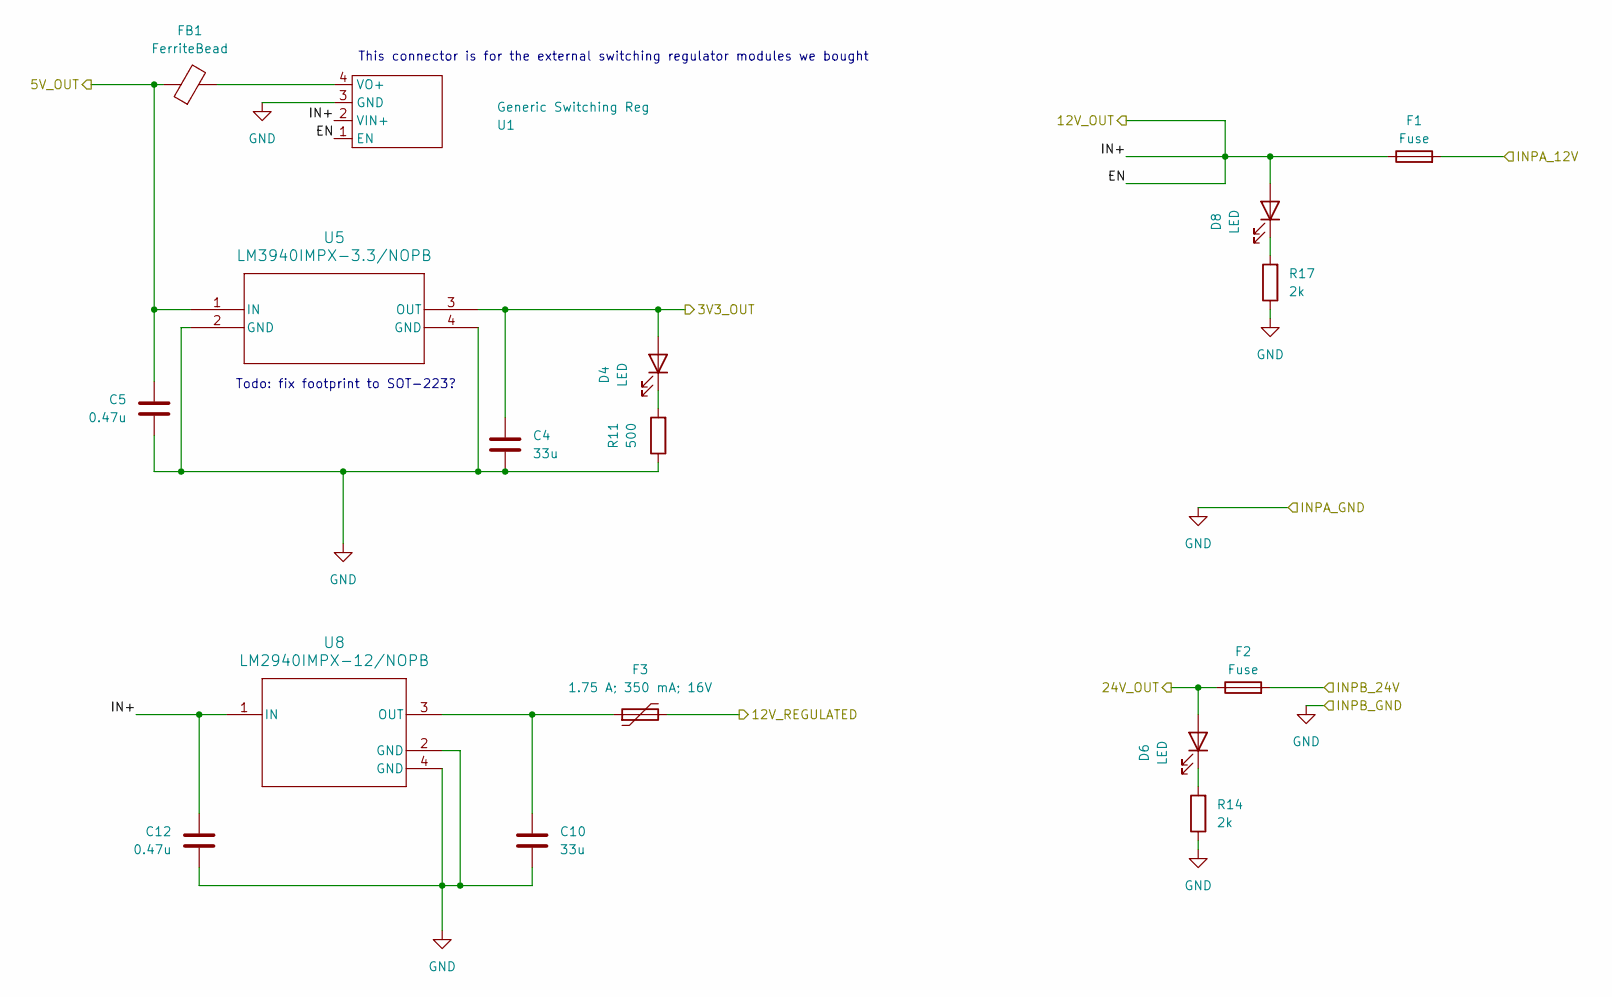
[picture p55: schematic power.kicad_sch]

Parts:
C4, C10: 33u; C_0603_1608Metric_Pad1.08x0.95mm_HandSolder
C5, C12: 0.47u; C_0603_1608Metric_Pad1.08x0.95mm_HandSolder
D4, D6, D8: LED; LED_0805_2012Metric_Pad1.15x1.40mm_HandSolder
F1, F2: Fuse; 3557-2; Mouser# 534-3557-2
F3: 1.75 A; 350 mA; 16V; Fuse_0805_2012Metric_Pad1.15x1.40mm_HandSolder; Mouser# 652-MF-PSHT035KX-2
FB1: FerriteBead; L_0805_2012Metric_Pad1.15x1.40mm_HandSolder; Mouser# 81-BLM18KG102SN1D
R11: 500; R_0603_1608Metric_Pad0.98x0.95mm_HandSolder
R14, R17: 2k; R_0603_1608Metric_Pad0.98x0.95mm_HandSolder
U1: Generic Switching Reg; generic_regulator
U5: LM3940IMPX-3.3/NOPB; SOT-223
U8: LM2940IMPX-12/NOPB; DCY0004A_N

Connections:
3V3_OUT: C4.1, D4.2 (A), U5.3 (OUT)
5V_OUT: C5.1, FB1.1, U5.1 (IN)
12V_OUT: C12.1, D8.2 (A), F1.1, U1.1 (EN), U1.2 (VIN+), U8.1 (IN)
12V_REGULATED: F3.2
24V_OUT: D6.2 (A), F2.1
GND: C4.2, C5.2, C10.2, C12.2, R11.1, R14.1, R17.1, U1.3 (GND), U5.2 (GND), U5.4 (GND), U8.2 (GND), U8.4 (GND)
INPA_12V: F1.2
INPB_24V: F2.2
unnamed: C10.1, F3.1, U8.3 (OUT)
unnamed: D4.1 (K), R11.2
unnamed: D6.1 (K), R14.2
unnamed: D8.1 (K), R17.2
unnamed: FB1.2, U1.4 (VO+)

Notes on the sheet:
This connector is for the external switching regulator modules we bought
Todo: fix footprint to SOT-223?
