aesirkth/surtr-hardware/thermocouple.kicad_sch

## KiCad design thermocouple.kicad_sch (2024-05-01)

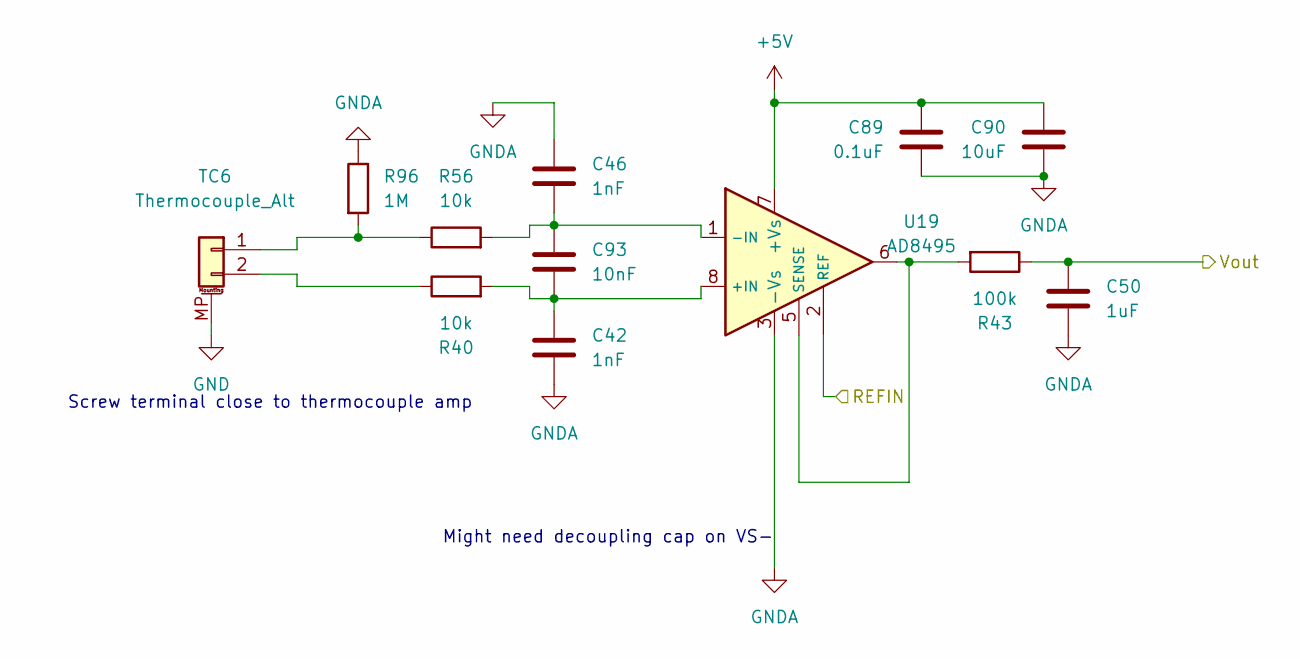
[picture p56: schematic thermocouple.kicad_sch]

Parts:
C42, C46: 1nF; C_0603_1608Metric_Pad1.08x0.95mm_HandSolder
C50: 1uF; C_0603_1608Metric_Pad1.08x0.95mm_HandSolder
C89: 0.1uF; C_0603_1608Metric_Pad1.08x0.95mm_HandSolder
C90: 10uF; C_0603_1608Metric_Pad1.08x0.95mm_HandSolder
C93: 10nF; C_0603_1608Metric_Pad1.08x0.95mm_HandSolder
R40, R56: 10k; R_0603_1608Metric_Pad0.98x0.95mm_HandSolder
R43: 100k; R_0603_1608Metric_Pad0.98x0.95mm_HandSolder
R96: 1M; R_0603_1608Metric_Pad0.98x0.95mm_HandSolder
TC6: Thermocouple_Alt; JST_GH_BM02B-GHS-TBT_1x02-1MP_P1.25mm_Vertical
U19: AD8495; MSOP-8_3x3mm_P0.65mm

Connections:
+5V: C89.1, C90.1, U19.7 (+Vs)
GND: TC6.MP (MountPin)
GNDA: C42.2, C46.1, C50.2, C89.2, C90.2, R96.1, U19.3 (-Vs)
unnamed: C42.1, C93.2, R40.2, U19.8 (+IN)
unnamed: C46.2, C93.1, R56.2, U19.1 (-IN)
unnamed: R40.1, TC6.2
unnamed: R43.2, U19.5 (SENSE), U19.6
unnamed: R56.1, R96.2, TC6.1
REFIN: U19.2 (REF)
Vout: C50.1, R43.1

Notes on the sheet:
Might need decoupling cap on VS-
Screw terminal close to thermocouple amp
