aesirkth/surtr-hardware/voltage_input_filtering.kicad_sch

## KiCad design voltage_input_filtering.kicad_sch (2024-05-01)

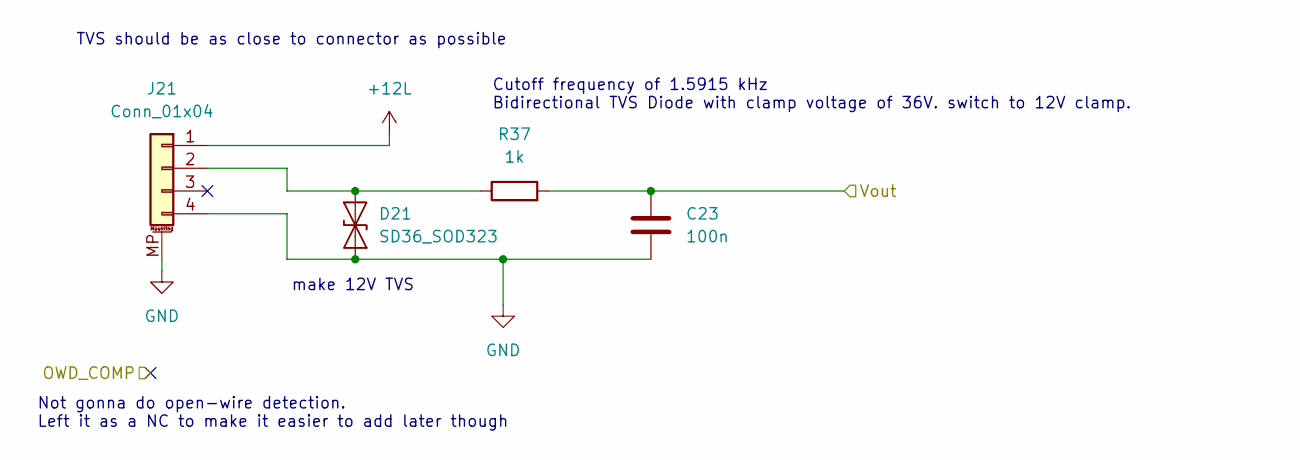
[picture p57: schematic voltage_input_filtering.kicad_sch]

Parts:
C23: 100n; C_0603_1608Metric_Pad1.08x0.95mm_HandSolder
D21: SD36_SOD323; D_SOD-323_HandSoldering; Mouser# 576-SD36C-01FTG
J21: Conn_01x04; JST_GH_BM04B-GHS-TBT_1x04-1MP_P1.25mm_Vertical
R37: 1k; R_0603_1608Metric_Pad0.98x0.95mm_HandSolder

Connections:
+12L: J21.1
GND: C23.2, D21.1 (A1), J21.4, J21.MP (MountPin)
unnamed: D21.2 (A2), J21.2, R37.1
Vout: C23.1, R37.2

Notes on the sheet:
Cutoff frequency of 1.5915 kHz Bidirectional TVS Diode with clamp voltage of 36V. switch to 12V clamp.
make 12V TVS
Not gonna do open-wire detection. Left it as a NC to make it easier to add later though
TVS should be as close to connector as possible
