aesirkth/surtr-hardware/(commit log)

2024-04-30 routing done
    [launchpad-controller-v2.kicad_sch]
2024-04-30 pin functions
    [launchpad-controller-v2.kicad_sch]
2024-05-06 ordered v1.0
    [launchpad-controller-v2-CuBottom.gbr, launchpad-controller-v2-CuIn1.gbr, launchpad-controller-v2-CuIn2.gbr, launchpad-controller-v2-CuTop.gbr, launchpad-controller-v2-EdgeCuts.gbr, launchpad-controller-v2-MaskBottom.gbr, launchpad-controller-v2-MaskTop.gbr, launchpad-controller-v2-NPTH.drl]
